davide97g/keybordy/cad/out/stl/plate.stl

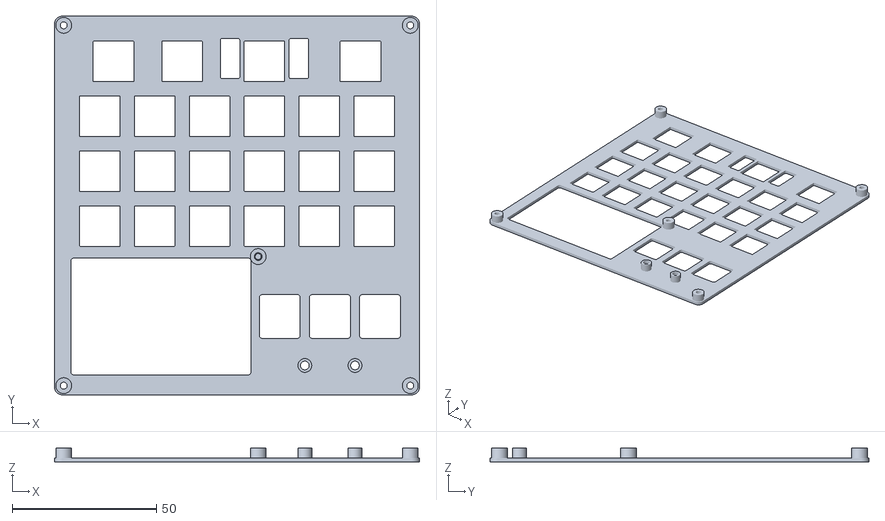
[picture p3: CAD file, 2026-10-20]
cad/out/stl/plate.stl
126.7 x 131.5 x 5.00
