davide97g/keybordy/cad/out/stl/tray.stl

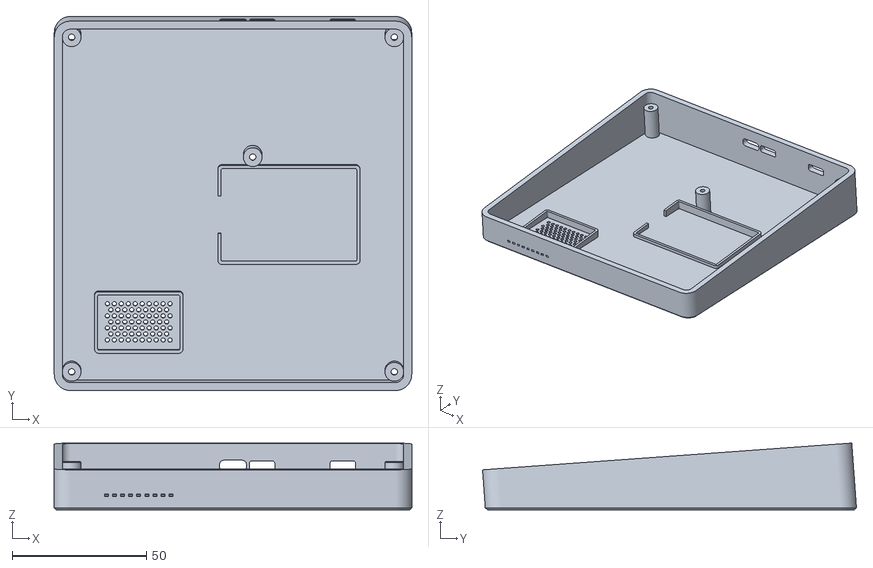
[picture p4: CAD file, 2026-10-20]
cad/out/stl/tray.stl
133.3 x 139.4 x 24.9
