davide97g/keybordy/cad/out/stl/cap15.stl

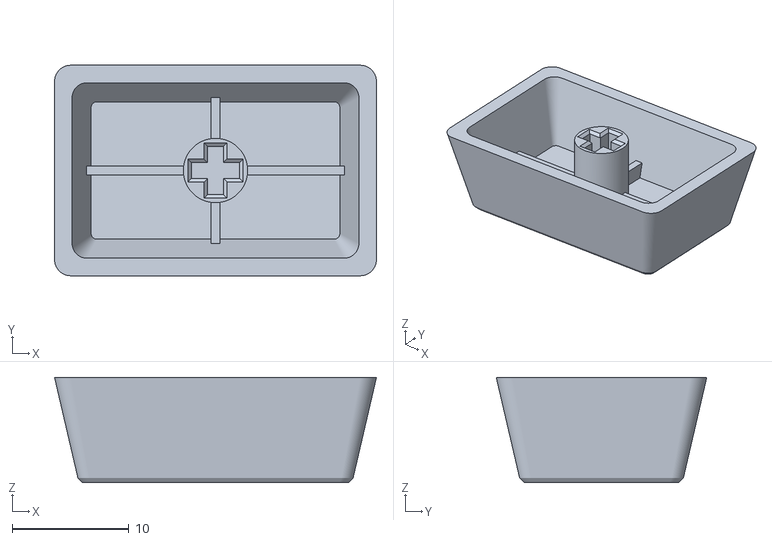
[picture p5: CAD file, 2026-10-20]
cad/out/stl/cap15.stl
27.5 x 18.0 x 9.00
