davide97g/keybordy/cad/out/stl/cap1.stl

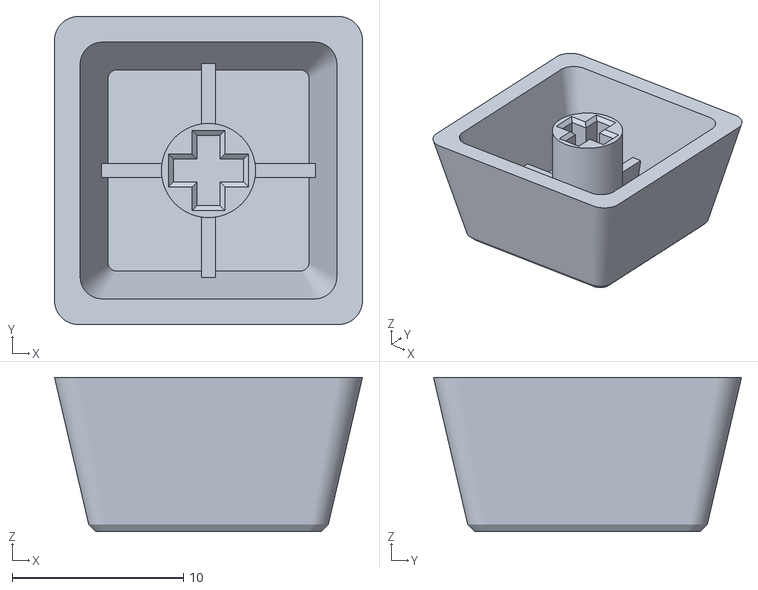
[picture p6: CAD file, 2026-10-20]
cad/out/stl/cap1.stl
18.0 x 18.0 x 9.00
