davide97g/keybordy/cad/out/stl/cap2_talk.stl

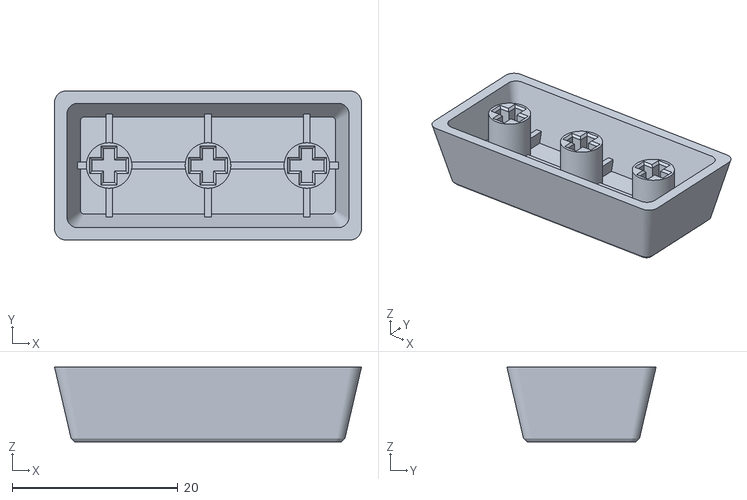
[picture p7: CAD file, 2026-10-20]
cad/out/stl/cap2_talk.stl
37.0 x 18.0 x 9.00
