davide97g/keybordy/cad/out/stl/deck.stl

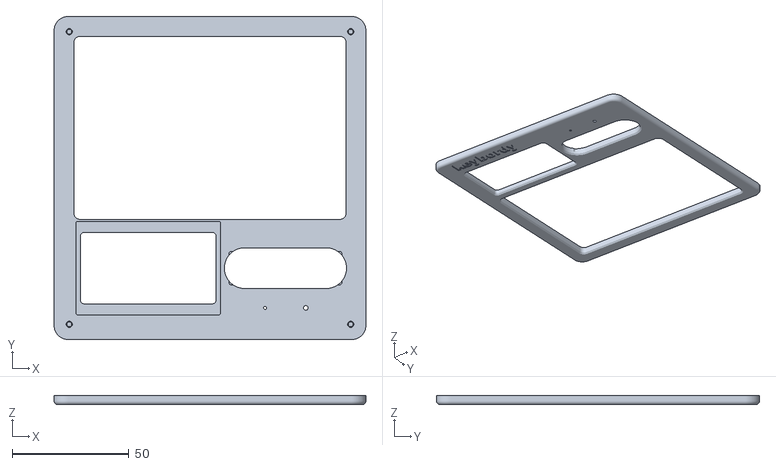
[picture p8: CAD file, 2026-10-20]
cad/out/stl/deck.stl
133.3 x 138.1 x 4.00
