davide97g/keybordy/cad/out/stl/knob.stl

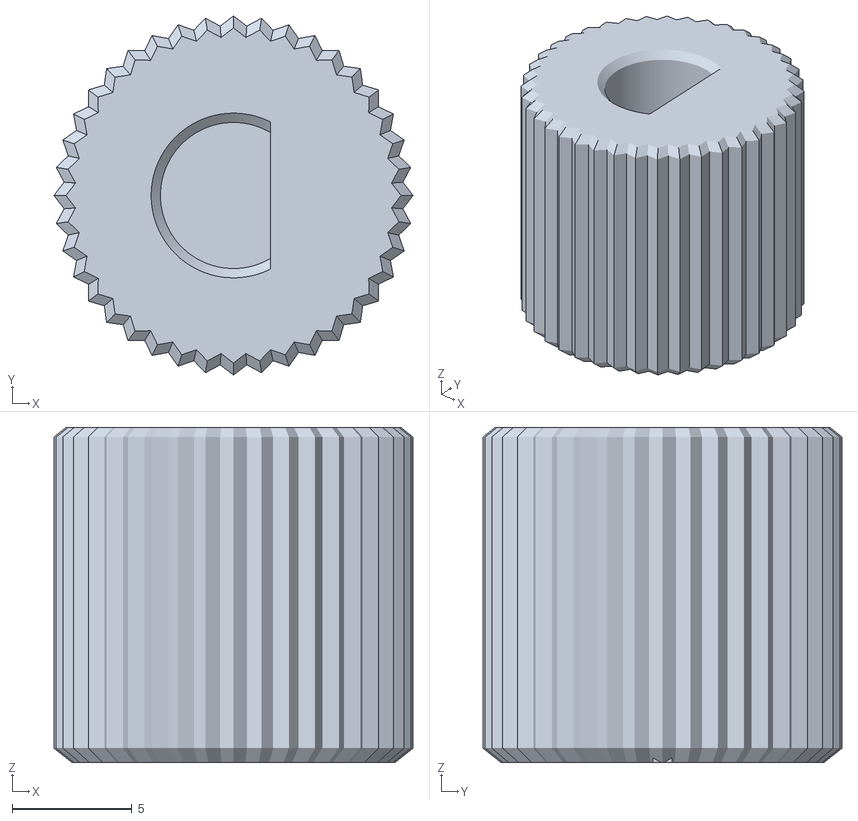
[picture p9: CAD file, 2026-10-20]
cad/out/stl/knob.stl
15.0 x 15.0 x 14.0
