davide97g/keybordy/pcb/keybordy.kicad_pcb

## KiCad design pcb/keybordy.kicad_pcb (2026-10-07)

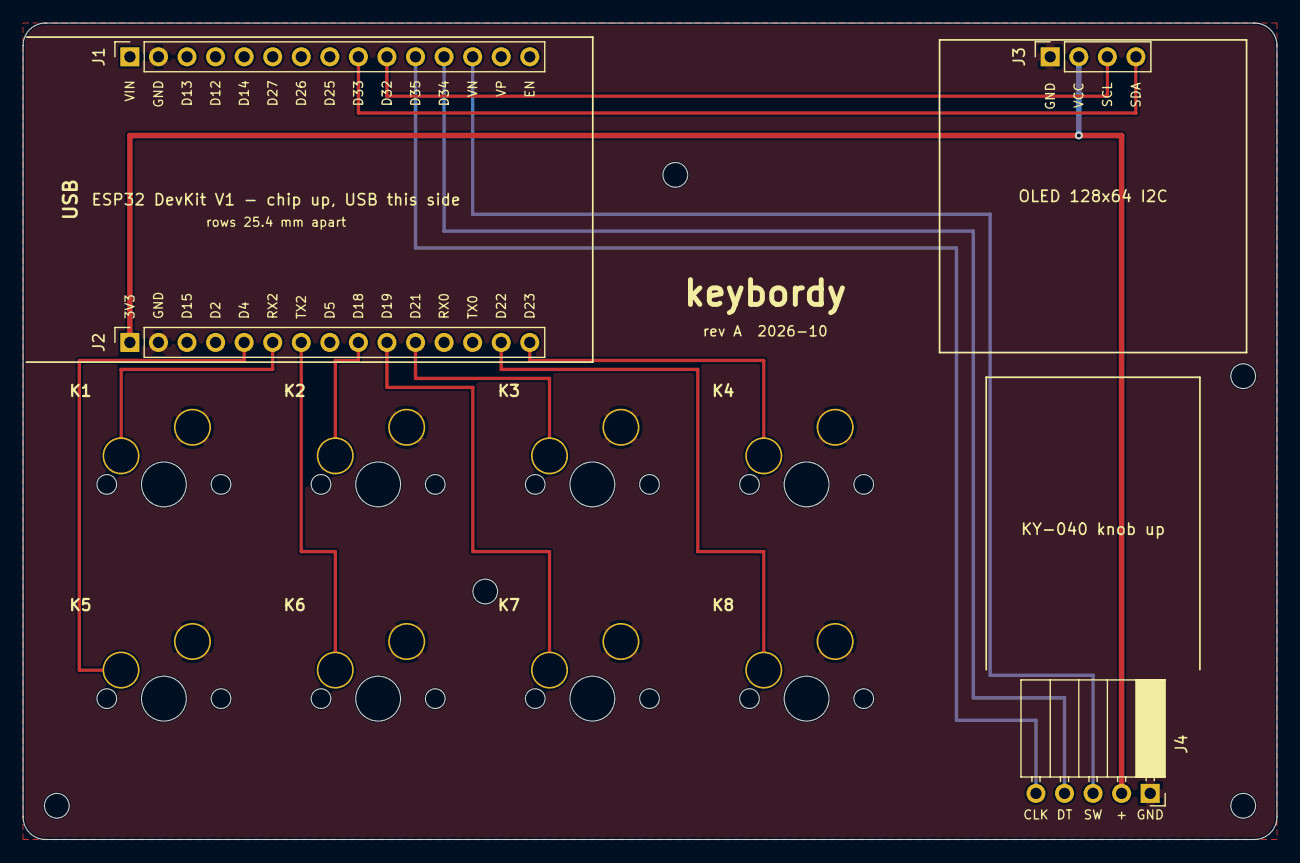
[picture p10: board keybordy.kicad_pcb from above]

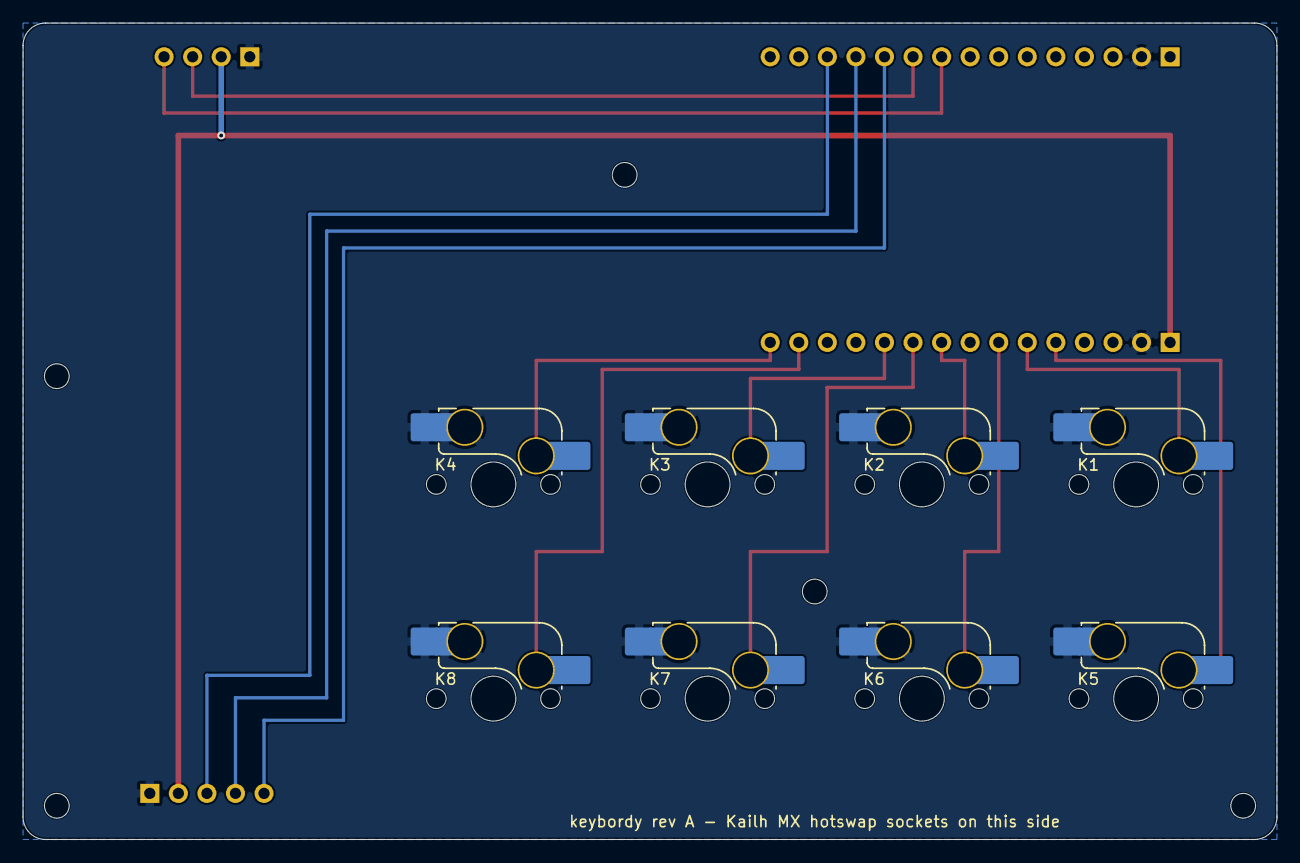
[picture p11: board keybordy.kicad_pcb from below]

Board: 2 copper layers, 111.5 x 72.6 mm, 17 parts (8 on the bottom side), 15 nets.

Parts:
H1, H2, H3, H4, H5: M2; MountingHole_2.2mm_M2
J1: DevKit top row; PinSocket_1x15_P2.54mm_Vertical
J2: DevKit bottom row; PinSocket_1x15_P2.54mm_Vertical
J3: SSD1306 OLED; PinSocket_1x04_P2.54mm_Vertical
J4: KY-040 rotary; PinSocket_1x05_P2.54mm_Horizontal
K1, K2, K3, K4, K5, K6, K7, K8: Kailh MX hotswap; SW_MX_HS_CPG151101S11_1u

Connections:
+3V3: J2.1, J3.2, J4.2
GND: J1.2, J2.2, J3.1, J4.1, K1.2, K2.2, K3.2, K4.2, K5.2, K6.2, K7.2, K8.2
KEY1: J2.6, K1.1
KEY2: J2.9, K2.1
KEY3: J2.11, K3.1
KEY4: J2.15, K4.1
KEY5: J2.5, K5.1
KEY6: J2.7, K6.1
KEY7: J2.10, K7.1
KEY8: J2.14, K8.1
OLED_SCL: J1.10, J3.3
OLED_SDA: J1.9, J3.4
ROT_CLK: J1.11, J4.5
ROT_DT: J1.12, J4.4
ROT_SW: J1.13, J4.3
