davide97g/keybordy/sim/velxio/backend/app/services/espidf_compiler.py

"""
ESP-IDF Compilation Service for ESP32 targets.

Replaces arduino-cli for ESP32/ESP32-C3 compilation.  User Arduino sketches
are compiled using ESP-IDF (with optional Arduino-as-component) to produce
firmware that boots reliably in the lcgamboa QEMU fork.

The key difference vs arduino-cli: ESP-IDF gives control over bootloader,
sdkconfig, and flash mapping — all of which must be QEMU-compatible.

Two compilation modes:
  1. Arduino-as-component: Full Arduino API (WiFi.h, WebServer.h, etc.)
     compiled through idf.py.  Requires ARDUINO_ESP32_PATH env var.
  2. Pure ESP-IDF: Translates common Arduino patterns to ESP-IDF C APIs.
     Fallback when Arduino component is not installed.
"""
import asyncio
import base64
import hashlib
import json
import logging
import os
import re
import shutil
import string
import subprocess
import tempfile
import threading
import time
from collections import deque
from contextvars import ContextVar
from dataclasses import dataclass
from pathlib import Path, PurePosixPath
from typing import Callable, Optional

logger = logging.getLogger(__name__)

# Per-task timing of the LAST compile() call: how long it waited for its build
# dir, whether the configure was skipped, and how long cmake / ninja ran. A
# caller can read it right after `await compile()` (same asyncio task, so the
# ContextVar is visible). Kept out of the result dict on purpose: the result is
# what the client receives, and these are diagnostics, not user-facing.
build_timing: ContextVar[Optional[dict]] = ContextVar('espidf_build_timing', default=None)


def _timing_note(**fields) -> None:
    current = build_timing.get() or {}
    current.update(fields)
    build_timing.set(current)


# Set VELXIO_ESPIDF_ALWAYS_CONFIGURE=1 to run `cmake` before every ninja run
# (the pre-2026-09 behaviour) without rebuilding the image. The default lets a
# warm build dir go straight to ninja, which re-runs cmake by itself when a
# configure input changed (build.ninja's RERUN_CMAKE rule).
_ALWAYS_CONFIGURE = (
    os.environ.get('VELXIO_ESPIDF_ALWAYS_CONFIGURE', '')
    in ('1', 'true', 'True', 'yes')
)


def _write_if_changed(path: Path, text: str) -> bool:
    """Write `text` to `path` only when the bytes differ. Returns True if written.

    Every generated file that cmake lists as a configure dependency
    (partitions.csv, velxio_board.cmake, a component's CMakeLists.txt) must go
    through here: an unconditional write bumps the mtime, and ninja's
    RERUN_CMAKE rule then re-runs the whole configure for a file that did not
    change. That configure is 60% of a warm ESP32 build (measured 2026-09-04).
    """
    try:
        if path.exists() and path.read_text(encoding='utf-8') == text:
            return False
    except (OSError, UnicodeDecodeError):
        pass
    path.write_text(text, encoding='utf-8')
    return True


# Location of the ESP-IDF project template (relative to this file)
_TEMPLATE_DIR = Path(__file__).parent / 'esp-idf-template'

# Files this pipeline owns inside main/ in Arduino mode: the app_main() wrapper
# that calls setup()/loop() (main.cpp), the pure-C twin the template ships,
# the translated sketch, the compat header and the two configure inputs. A
# user file with one of these names used to be written straight over them.
# Measured 2026-09-15: a project carrying its own `main.cpp` (a helper, no
# app_main) shadowed the wrapper, left a main.cpp.obj without the symbol in
# the shared variant dir, and every Arduino build that landed there for the
# next nine hours failed with "undefined reference to app_main" (573 builds,
# 73 users). Compared case-insensitively: on a Windows or macOS host
# Main.cpp and main.cpp are the same file.
_MAIN_RESERVED_NAMES = frozenset(n.casefold() for n in (
    'main.cpp',
    'main.c',
    'sketch.ino.cpp',
    'sketch_translated.c',
    'velxio_compat.h',
    'CMakeLists.txt',
    'idf_component.yml',
))
_USER_FILE_PREFIX = 'user_'
# What the template's main/CMakeLists.txt globs into the main component.
_COMPILED_SUFFIXES = ('.c', '.cpp')


def _user_main_name(name: str) -> str | None:
    """File name inside main/ that a user file is written under in Arduino
    mode, or None when the name is unusable.

    Only the last path component is kept, the way the pure ESP-IDF branch
    already does it. main/ is flat: the template CMake globs its top level
    only (a source in a sub-directory never compiled) and the write never
    created the parent (it crashed instead). And a name with '..' or an
    absolute path must never leave main/: the process runs as root in a build
    dir other users share. A basename the template owns gets the `user_`
    prefix, so the user's code still compiles and the wrapper stays.
    """
    base = PurePosixPath(str(name or '').replace('\\', '/')).name
    if base in ('', '.', '..'):
        return None
    if base.casefold() in _MAIN_RESERVED_NAMES:
        return _USER_FILE_PREFIX + base
    return base


def _defines_app_main(code: str) -> bool:
    """True when real code (not a comment or a string) defines app_main()."""
    return bool(re.search(r'\bvoid\s+app_main\s*\(', _blank_noncode(code)))


def _missing_app_main(output: str) -> bool:
    """The link failed because nothing defined app_main()."""
    return "undefined reference to `app_main'" in output


def _write_arduino_user_files(
    main_dir: Path,
    files: list[dict],
    entry_file: dict | None,
    progress_callback: Optional[Callable[[str], None]] = None,
) -> str | None:
    """Write the non-.ino files of an Arduino-mode build into main/.

    Returns an error message for the user, or None.

    - `entry_file` is the file compile() used as the sketch because there is
      no .ino (files[0]). It already reaches the build as sketch.ino.cpp, so a
      .c/.cpp entry is not written again (it used to compile twice, once as
      C). A header entry is still written: other files include it.
    - Names go through _user_main_name: flattened, kept inside main/, and a
      name the template owns renamed to `user_<name>`.
    - Two files that would land on the same name are an error, not a silent
      overwrite.
    - A user source that defines its own app_main() replaces the template
      wrapper for this build. That is a custom entry point, and it used to
      work by overwriting main.cpp, so it has to keep working. The wrapper is
      deleted rather than shadowed; it comes back from the template on the
      next build and _advance_changed_inputs gives it a new mtime, so no
      object from this build can outlive it.
    """
    def note(text: str) -> None:
        logger.warning(f'[espidf] {text}')
        if progress_callback is not None:
            try:
                progress_callback(f'[velxio] {text}\n')
            except Exception:
                pass

    written: dict[str, str] = {}
    custom_entry: str | None = None
    for f in files:
        name = str(f.get('name') or '')
        if name.endswith('.ino'):
            continue
        if f is entry_file and name.endswith(_COMPILED_SUFFIXES):
            continue
        target = _user_main_name(name)
        if target is None:
            note(f'skipped a file with an unusable name: {name!r}')
            continue
        if target in written:
            return (
                f'"{name}" and "{written[target]}" would both be compiled as '
                f'{target}. Rename one of them.'
            )
        written[target] = name
        if target != PurePosixPath(name.replace('\\', '/')).name:
            note(
                f'{name} is a name the build wrapper uses; your file is '
                f'compiled as {target}'
            )
        content = f.get('content', '')
        (main_dir / target).write_text(content, encoding='utf-8')
        if (
            custom_entry is None
            and target.endswith(_COMPILED_SUFFIXES)
            and _defines_app_main(content)
        ):
            custom_entry = target
    if custom_entry is not None:
        (main_dir / 'main.cpp').unlink(missing_ok=True)
        note(
            f'{custom_entry} defines app_main(); it replaces the Arduino '
            'setup()/loop() wrapper'
        )
    return None


# Per variant: what each tracked input held, and the mtime it was left with.
_INPUT_DIGESTS = '.velxio-input-digests.json'
# The per-build inputs this pipeline recreates (the rest of the project dir is
# either generated through _write_if_changed or owned by cmake/ninja).
_TRACKED_INPUT_DIRS = ('main', 'user_libs')


def _advance_changed_inputs(project_dir: Path) -> int:
    """Keep ninja's mtime test honest for every file this pipeline recreates.

    ninja rebuilds an object only when one of its inputs is NEWER than it.
    Everything under main/ and user_libs/ is recreated on every build, and
    copytree / copy2 hand each file the mtime of its SOURCE: the template's
    (months old) or the library cache's. A path whose content changes while
    its mtime stays in the past therefore keeps the object built from the old
    content, forever, in a build dir other users share. That is the 2026-09-15
    outage (a user main.cpp left a main.cpp.obj without app_main, the wrapper
    came back with its June mtime, and ninja never looked at it again), and a
    library version bump in the scan-all view has the same shape.

    The invariant: for a given path the mtime never goes backwards, and it
    moves forward whenever the content changes.
      - content differs from the last build, or the path is new: mtime = now
      - same content, but the copy moved the mtime into the past: the mtime it
        had after the last build is restored, so nothing rebuilds needlessly
      - same content, same or newer mtime: left alone (a warm build stays warm)
    A dir with no record yet treats every file as changed. That costs one
    rebuild of the main component and the user libraries (ccache hits), and it
    repairs a dir poisoned before this existed.

    Returns the number of files whose mtime was moved.
    """
    record_path = project_dir / _INPUT_DIGESTS
    try:
        previous = json.loads(record_path.read_text(encoding='utf-8'))
        if not isinstance(previous, dict):
            previous = {}
    except (OSError, ValueError):
        previous = {}
    now_ns = time.time_ns()
    current: dict[str, list] = {}
    moved = 0
    for root_name in _TRACKED_INPUT_DIRS:
        root = project_dir / root_name
        if not root.is_dir():
            continue
        for dirpath, _dirnames, filenames in os.walk(root):
            for fname in filenames:
                path = Path(dirpath) / fname
                if path.is_symlink() or not path.is_file():
                    continue
                rel = path.relative_to(project_dir).as_posix()
                try:
                    digest = hashlib.sha256(path.read_bytes()).hexdigest()
                    mtime_ns = path.stat().st_mtime_ns
                except OSError:
                    continue
                prev = previous.get(rel)
                target_ns = None
                if not (isinstance(prev, list) and len(prev) == 2 and prev[0] == digest):
                    target_ns = now_ns
                elif isinstance(prev[1], int) and mtime_ns < prev[1]:
                    target_ns = prev[1]
                if target_ns is not None:
                    try:
                        os.utime(path, ns=(target_ns, target_ns))
                        mtime_ns = target_ns
                        moved += 1
                    except OSError:
                        pass
                current[rel] = [digest, mtime_ns]
    try:
        tmp = project_dir / (_INPUT_DIGESTS + '.tmp')
        tmp.write_text(json.dumps(current), encoding='utf-8')
        os.replace(tmp, record_path)
    except OSError:
        pass
    return moved


# ── Persistent build dir ─────────────────────────────────────────────────────
# Cold ESP-IDF compiles rebuild ~1480 base objects (FreeRTOS, lwIP, esp_wifi,
# libsodium, …). The default tempfile.TemporaryDirectory flow gave each compile
# a fresh path under /tmp/espidf_<random>/, which baked into -I and
# -fmacro-prefix-map flags and made ccache 0% effective (different cwd → hash
# miss every time). With the persistent dir, /var/lib/velxio-build/<target>/
# is a stable anchor: ninja's incremental cache + ccache hits combine to bring
# warm compiles down to ~5-30s.
#
# Concurrent compiles in the SAME variant dir would corrupt it; they're
# serialised by _variant_lock below (one lock per variant, or per replica of a
# variant). Different variants of one target, and different targets, run in
# parallel up to the build queue's slot count.
#
# Set VELXIO_PERSISTENT_BUILD_DIR=0 to fall back to the legacy tempfile flow
# without rebuilding the image (escape hatch if the persistent dir misbehaves
# in production).
_BUILD_ROOT = Path(os.environ.get('VELXIO_BUILD_ROOT', '/var/lib/velxio-build'))
_USE_PERSISTENT_DIR = (
    os.environ.get('VELXIO_PERSISTENT_BUILD_DIR', '1')
    not in ('0', 'false', 'False', '')
)


# ── Per-library include roots (Arduino-faithful layout) ──────────────────────
# The merged `user_libs_all` component used to copy every library's files into
# ONE interleaved tree and then put EVERY directory that held a file on the
# component's public INCLUDE_DIRS. That is the root cause of the header-shadow
# bug class: a library's private internals — FastLED's host-test
# `src/platforms/stub/Arduino.h`, its `src/fl/stl/asio/http/http_parser.h`,
# LovyanGFX's `src/lgfx/internal/limits.h` — landed on the global -I and
# hijacked `#include`s issued by OTHER libraries, by the arduino-esp32 core and
# by ESP-IDF itself. Every fix was another name in `_SHADOW_STD_HEADERS`, i.e.
# chasing symptoms: the denylist grows with every library that ships a
# generically-named internal header.
#
# arduino-cli — the resolver every other Velxio board family already delegates
# to — shares one global -I list too, but adds exactly ONE directory per
# library: `<lib>/src` for the recursive layout, `<lib>` for the legacy flat
# one, never a subdirectory (its header index is non-recursive, so
# `src/sub/foo.h` is only ever reachable as `<sub/foo.h>`). `utility/` stays
# private to the library that owns it. arduino-esp32 does the same as an IDF
# component: one public include dir per bundled library.
#
# So: keep the single component — a component per library would trade this bug
# for REQUIRES-order shadowing (IDF exports component includes as plain -I,
# never -isystem) plus IDF-component name collisions — but give each library
# its own subtree and publish only its include root.
#
# Set VELXIO_PER_LIB_ROOTS=0 to fall back to the legacy interleaved layout
# without rebuilding the image (rollback hatch).
_PER_LIB_ROOTS = (
    os.environ.get('VELXIO_PER_LIB_ROOTS', '1')
    not in ('0', 'false', 'False', '')
)


# Directories a library ships that are never compiled: documentation and
# support material per the Arduino library spec. Headers found ONLY here do
# not get to add dependencies to the build (see the transitive scan below).
_SUPPORT_ONLY_DIRS = frozenset({
    'extras', 'examples', 'example', 'test', 'tests', 'docs', 'doc',
    'benchmark', 'benchmarks', 'fuzz', 'fuzzing', 'ci',
})

# A compiled source reaching into one of those dirs, e.g. FirebaseJson's
# `#include "extras/print/printf.h"` or FastLED's unity build.
_SUPPORT_INCLUDE_RE = re.compile(
    r'#\s*include\s*[<"][^">]*\b(?:%s)/' % '|'.join(sorted(_SUPPORT_ONLY_DIRS)),
    re.IGNORECASE,
)


def _sanitise_lib_dirname(name: str) -> str:
    """Component-relative directory name for a library.

    Cache folder names carry `@version-hash` suffixes (`fastled@3.10.5-017d…`)
    and user libs can be named anything; keep the characters that are safe in a
    path AND inside a quoted CMake string, fold the rest.
    """
    safe = re.sub(r'[^A-Za-z0-9_.@-]', '_', name).strip('.')
    return safe or 'lib'


def _idf_version_signature() -> str:
    """Snapshot of the ESP-IDF + arduino-esp32 toolchain version. Used to
    invalidate persistent build dirs after an upstream submodule bump (the
    cached object files on disk are no longer ABI-compatible)."""
    parts = []
    idf_version_file = Path('/opt/esp-idf/version.txt')
    if idf_version_file.exists():
        parts.append(idf_version_file.read_text(encoding='utf-8').strip())
    arduino_version_file = Path('/opt/arduino-esp32/version.txt')
    if arduino_version_file.exists():
        parts.append(arduino_version_file.read_text(encoding='utf-8').strip())
    if not parts:
        # Fall back to mtime of the IDF tree root — coarse but stable per
        # image build.
        try:
            parts.append(str(int(Path('/opt/esp-idf').stat().st_mtime)))
        except OSError:
            parts.append('unknown')
    return '|'.join(parts)


# Type for live progress callback. Called from a worker thread for every
# stdout/stderr line as the build runs. Implementations should be cheap and
# thread-safe (callers commonly stash lines into a dict shared with the main
# event loop). Exceptions raised from the callback are swallowed so a faulty
# UI hook can never break the build.
ProgressCallback = Callable[[str], None]


@dataclass
class _RunResult:
    """Drop-in replacement for the fields we read off subprocess.CompletedProcess."""
    returncode: int
    stdout: str
    stderr: str


def _nice_preexec(nice: int | None):
    """preexec_fn that lowers the child's CPU priority. None = inherit.

    The API and the simulation WebSockets share the box with the compilers;
    a positive nice keeps them responsive under a full CPU. Background
    replica warm-ups run at nice 10 so they never compete with a build
    someone is waiting on.
    """
    if not nice or os.name == 'nt':
        return None

    def _apply() -> None:
        try:
            os.nice(int(nice))
        except OSError:
            pass
    return _apply


def _run_with_streaming(
    cmd: list[str],
    *,
    cwd: str,
    env: dict[str, str],
    timeout: float,
    progress_callback: Optional[ProgressCallback],
    nice: int | None = None,
) -> _RunResult:
    """Run `cmd` synchronously and stream stdout + stderr line-by-line.

    Behaves like subprocess.run(capture_output=True, text=True) but invokes
    `progress_callback(line)` for every line as it arrives. When
    progress_callback is None this falls back to a single subprocess.run call
    so we don't pay the threading cost on the unit-test path that doesn't
    care about live output.

    Raises subprocess.TimeoutExpired on timeout (matches the existing flow).
    """
    preexec = _nice_preexec(nice)
    if progress_callback is None:
        cp = subprocess.run(
            cmd, cwd=cwd, env=env, capture_output=True, text=True, timeout=timeout,
            preexec_fn=preexec,
        )
        return _RunResult(returncode=cp.returncode, stdout=cp.stdout, stderr=cp.stderr)

    proc = subprocess.Popen(
        cmd,
        cwd=cwd,
        env=env,
        stdout=subprocess.PIPE,
        stderr=subprocess.PIPE,
        text=True,
        bufsize=1,  # line-buffered
        preexec_fn=preexec,
    )
    stdout_lines: list[str] = []
    stderr_lines: list[str] = []

    def _drain(stream, sink: list[str]) -> None:
        try:
            for line in iter(stream.readline, ''):
                sink.append(line)
                try:
                    progress_callback(line)
                except Exception:
                    # A faulty progress sink must never break the build.
                    pass
        finally:
            try:
                stream.close()
            except Exception:
                pass

    t_out = threading.Thread(target=_drain, args=(proc.stdout, stdout_lines), daemon=True)
    t_err = threading.Thread(target=_drain, args=(proc.stderr, stderr_lines), daemon=True)
    t_out.start()
    t_err.start()

    try:
        proc.wait(timeout=timeout)
    except subprocess.TimeoutExpired:
        proc.kill()
        # Give drain threads a chance to flush before we raise.
        t_out.join(timeout=2)
        t_err.join(timeout=2)
        raise

    t_out.join(timeout=5)
    t_err.join(timeout=5)
    return _RunResult(
        returncode=proc.returncode,
        stdout=''.join(stdout_lines),
        stderr=''.join(stderr_lines),
    )


# How many distinct build variants to keep per target before LRU-evicting the
# coldest. Each variant is a full ESP-IDF build tree (~240 MB). Distinct
# variants = distinct (board options x resolved library set). The global ccache
# means an evicted-then-rebuilt variant warms up in seconds.
# Was 12. Each variant is a FULL ~1 GB build tree holding its own copies of
# the same ESP-IDF component objects, so 46 of them had grown to 25 GB while
# ccache - the cache that actually serves EVERY target and variant - sat
# capped at 8 GB, permanently full (99.97%, 153 evictions, 47% hit rate).
# Fewer trees, a bigger shared cache: a variant that gets evicted rebuilds
# quickly FROM ccache, but a ccache miss recompiles from source.
_MAX_BUILD_VARIANTS = 6


def _max_build_variants(idf_target: str) -> int:
    """Variant cap for one target: VELXIO_BUILD_VARIANTS_<TARGET> (e.g.
    VELXIO_BUILD_VARIANTS_ESP32), else VELXIO_BUILD_VARIANTS, else the module
    default. Per target because on a busy server the hot target rotates through
    10 distinct variants in half an hour while the others idle at two."""
    for name in (f'VELXIO_BUILD_VARIANTS_{idf_target.upper()}', 'VELXIO_BUILD_VARIANTS'):
        raw = os.environ.get(name, '').strip()
        if raw:
            try:
                return max(1, min(64, int(raw)))
            except ValueError:
                logger.warning(f'[espidf] {name}={raw!r} is not an integer; ignored')
    return _MAX_BUILD_VARIANTS


# ── Replicas of a hot variant ────────────────────────────────────────────────
# Two compiles that hash to the SAME variant serialise on its lock, and on
# a busy multi-user server the dominant configuration (the default esp32 blink,
# no libraries) was 78% of all ESP-IDF builds: the second heavy slot spent its time
# holding a slot while waiting for the first one's directory. A replica is a
# second full copy of the variant (`v_<hash>_r1`), configured on first use and
# then as warm as the original, with its own lock. A compile picks the first
# replica whose lock is free. Replicas are only CREATED after the variant has
# been found busy a few times in a short window, so a one-off library
# combination never earns a second 400 MB tree.
def _variant_replicas() -> int:
    raw = os.environ.get('VELXIO_BUILD_VARIANT_REPLICAS', '').strip()
    if not raw:
        return 1
    try:
        return max(1, min(8, int(raw)))
    except ValueError:
        logger.warning(f'[espidf] VELXIO_BUILD_VARIANT_REPLICAS={raw!r} is not an integer; using 1')
        return 1


_REPLICA_COLLISION_THRESHOLD = 3     # busy hits before a new replica is created
_REPLICA_COLLISION_WINDOW_S = 600.0  # ...within this many seconds
_VARIANT_COLLISIONS: dict[str, deque] = {}
#: Lock keys of replicas being built in the background right now. A replica
#: is warmed by a background compile of the SAME sources (so its configure
#: matches the variant) rather than by the user's job that hit the collision:
#: a cold build is 30-75 s and that job would rather wait a few seconds for
#: the original. While warming, the replica is neither picked nor re-created.
_WARMING_REPLICAS: set[str] = set()
_BACKGROUND_TASKS: set = set()


def _note_variant_collision(base_key: str) -> bool:
    """Record that every replica of `base_key` was busy. True when the streak
    is long enough to justify creating the next replica."""
    now = time.monotonic()
    hits = _VARIANT_COLLISIONS.setdefault(base_key, deque())
    hits.append(now)
    while hits and now - hits[0] > _REPLICA_COLLISION_WINDOW_S:
        hits.popleft()
    return len(hits) >= _REPLICA_COLLISION_THRESHOLD


def _variant_dir_name(variant_key: str, replica: int = 0) -> str:
    safe = ''.join(c for c in variant_key if c.isalnum() or c in '-_')[:40] or 'default'
    return 'v_' + safe + (f'_r{replica}' if replica else '')


def _variant_lock_key(idf_target: str, variant_key: str, replica: int = 0) -> str:
    base = f'{idf_target}/{variant_key}'
    return base if not replica else f'{base}/r{replica}'


_VARIANT_DIR_RE = re.compile(r'^v_(.+?)(?:_r(\d+))?$')


def _lock_key_for_variant_dir(idf_target: str, dirname: str) -> str | None:
    """Inverse of _variant_dir_name: the lock key a `v_*` directory is built
    under, so eviction can tell whether someone is compiling in it."""
    m = _VARIANT_DIR_RE.match(dirname)
    if not m:
        return None
    return _variant_lock_key(idf_target, m.group(1), int(m.group(2) or 0))


# One compile at a time per build variant. The build queue bounds how many
# compiles run at once, not WHERE they run: two requests that hash to the same
# variant (the deploy gate's smoke fired the S3 OLED example twice, 13 s
# apart) shared one project dir, and the second configure walked into the
# first one's half-copied managed component. The component manager then
# reported it "corrupted" on every later attempt, and that variant was dead
# until someone deleted it by hand (2026-09-03).
_VARIANT_LOCKS: dict[str, asyncio.Lock] = {}
_VARIANT_LOCKS_GUARD = threading.Lock()


def _variant_lock(key: str) -> asyncio.Lock:
    """The lock that serialises compiles inside one persistent build variant."""
    with _VARIANT_LOCKS_GUARD:
        lock = _VARIANT_LOCKS.get(key)
        if lock is None:
            lock = _VARIANT_LOCKS[key] = asyncio.Lock()
        return lock


_CORRUPT_COMPONENT_RE = re.compile(
    r'The downloaded component "([^"]+)"\s+is\s+corrupted', re.IGNORECASE
)


def _corrupt_managed_component(stderr: str | None) -> str | None:
    """Name of the managed component the IDF component manager refused as
    corrupted (its message wraps across lines), or None for any other cmake
    failure."""
    m = _CORRUPT_COMPONENT_RE.search(stderr or '')
    return m.group(1) if m else None


def _heal_corrupt_managed_components(project_dir: Path, build_dir: Path) -> bool:
    """Drop the variant's managed_components/ (the component manager copies
    them back from its own intact cache on the next configure) and the cmake
    cache that recorded them. Returns True when there was something to drop."""
    removed = False
    managed = project_dir / 'managed_components'
    if managed.exists():
        shutil.rmtree(managed, ignore_errors=True)
        removed = True
    cache = build_dir / 'CMakeCache.txt'
    if cache.exists():
        cache.unlink(missing_ok=True)
        removed = True
    return removed


def _evict_cold_variants(target_dir: Path, keep: int, idf_target: str | None = None) -> None:
    """LRU-evict variant dirs (``v_*``) beyond ``keep``, coldest mtime first.

    Never evicts a variant whose lock is held: with two compiles of one target
    running at once (different variants, or replicas of one), the coldest
    sibling by mtime can be the one a long cold build is still writing into.
    Its mtime is stamped at prepare time and again when its build finishes
    (see _attempt), so a variant only looks cold once it has been idle.
    """
    try:
        variants = [
            d for d in target_dir.iterdir()
            if d.is_dir() and d.name.startswith('v_')
        ]
    except OSError:
        return
    if len(variants) <= keep:
        return
    target = idf_target or target_dir.name

    def _busy(d: Path) -> bool:
        key = _lock_key_for_variant_dir(target, d.name)
        if key is None:
            return False
        with _VARIANT_LOCKS_GUARD:
            lock = _VARIANT_LOCKS.get(key)
        return bool(lock is not None and lock.locked())

    variants.sort(key=lambda d: d.stat().st_mtime if d.exists() else 0.0)
    excess = len(variants) - keep
    for d in variants:
        if excess <= 0:
            break
        if _busy(d):
            logger.info(f'[espidf] not evicting {d.name}: a compile holds its lock')
            continue
        logger.info(f'[espidf] LRU-evicting cold build variant {d.name}')
        shutil.rmtree(d, ignore_errors=True)
        excess -= 1


def _ninja_parallelism_args() -> list[str]:
    """`-j N` / `-l L` for ninja from VELXIO_NINJA_JOBS / VELXIO_NINJA_LOAD_LIMIT.

    Unset (the default) leaves ninja's own choice, nproc + 2. Two heavy slots
    on 6 vCPU, where two such ninjas plus the light lane measured 34 runnable
    compiler threads at peak, are what these knobs are for. `-l` throttles on the 1-minute load average, so a
    build alone still gets the whole box.
    """
    args: list[str] = []
    raw_jobs = os.environ.get('VELXIO_NINJA_JOBS', '').strip()
    if raw_jobs:
        try:
            jobs = int(raw_jobs)
            if jobs > 0:
                args += ['-j', str(jobs)]
        except ValueError:
            logger.warning(f'[espidf] VELXIO_NINJA_JOBS={raw_jobs!r} is not an integer; ignored')
    raw_load = os.environ.get('VELXIO_NINJA_LOAD_LIMIT', '').strip()
    if raw_load:
        try:
            load = float(raw_load)
            if load > 0:
                args += ['-l', str(load)]
        except ValueError:
            logger.warning(f'[espidf] VELXIO_NINJA_LOAD_LIMIT={raw_load!r} is not a number; ignored')
    return args


_CONFIGURE_TROUBLE_MARKERS = (
    'CMake Error',
    'ninja: error',
    'missing and no known rule to make it',
    'error: loading \'build.ninja\'',
)


def _ninja_failure_wants_configure(result: _RunResult) -> bool:
    """True when a failed ninja run on a warm dir looks like a configure
    problem (cmake re-run failed, an input vanished, a manifest changed) rather
    than a compiler error in the user's code. The fast path falls back to the
    explicit configure exactly once on these."""
    text = (result.stdout or '') + '\n' + (result.stderr or '')
    if _corrupt_managed_component(text):
        return True
    return any(marker in text for marker in _CONFIGURE_TROUBLE_MARKERS)


def _ninja_log_step_count(build_dir: 'str | Path') -> int:
    """Number of completed build steps recorded in ``build_dir/.ninja_log``
    (0 when absent/unreadable). Diagnostics only — used to say how far a
    timed-out build got."""
    try:
        with open(Path(build_dir) / '.ninja_log', encoding='utf-8', errors='replace') as fh:
            return max(0, sum(1 for _ in fh) - 1)  # first line is the header
    except OSError:
        return 0


# ── .ino prototype generation ────────────────────────────────────────────────
# arduino-cli runs ctags over the sketch and injects forward declarations so
# the classic Arduino idiom — helpers defined AFTER setup()/loop() that use
# them — compiles. This pipeline writes sketch.ino.cpp itself and never did,
# so every such sketch died with "'foo' was not declared in this scope".
# This is a conservative ctags stand-in: it only emits prototypes for
# top-level, single-signature-line function definitions and skips anything
# ambiguous (templates, methods, default args, function-pointer params).

_INO_CTRL_KEYWORDS = frozenset((
    'if', 'else', 'for', 'while', 'switch', 'do', 'return', 'sizeof',
    'catch', 'case', 'new', 'delete', 'throw', 'goto',
))

_INO_FUNC_RE = re.compile(
    r'^[ \t]*([A-Za-z_][A-Za-z0-9_:<>,\*&\s]*?[\s\*&])'   # return type part
    r'([A-Za-z_]\w*)'                                      # function name
    r'[ \t]*\(([^;{}()]*)\)'                               # params (no nesting)
    r'[ \t\r\n]*\{',
    re.M,
)


def _blank_noncode(source: str) -> str:
    """Return a same-length copy with comments, string/char literals and
    preprocessor lines replaced by spaces (newlines preserved), so brace
    counting and signature matching never trip on their contents."""
    out = list(source)
    i, n = 0, len(source)
    line_start = True
    while i < n:
        c = source[i]
        if line_start and source[i:].lstrip(' \t')[:1] == '#':
            # blank the whole preprocessor line (incl. continuations)
            while i < n:
                if source[i] == '\n' and source[i - 1] != '\\':
                    break
                if source[i] != '\n':
                    out[i] = ' '
                i += 1
            line_start = True
            i += 1
            continue
        line_start = c == '\n'
        if c == '/' and i + 1 < n and source[i + 1] == '/':
            while i < n and source[i] != '\n':
                out[i] = ' '
                i += 1
            continue
        if c == '/' and i + 1 < n and source[i + 1] == '*':
            out[i] = out[i + 1] = ' '
            i += 2
            while i < n and not (source[i] == '*' and i + 1 < n and source[i + 1] == '/'):
                if source[i] != '\n':
                    out[i] = ' '
                i += 1
            if i < n:
                out[i] = out[i + 1] = ' '
                i += 2
            continue
        if c in ('"', "'"):
            quote = c
            i += 1
            while i < n and source[i] != quote:
                if source[i] == '\\':
                    out[i] = ' '
                    i += 1
                    if i < n and source[i] != '\n':
                        out[i] = ' '
                    i += 1
                    continue
                if source[i] != '\n':
                    out[i] = ' '
                i += 1
            i += 1
            continue
        i += 1
    return ''.join(out)


def generate_ino_prototypes(source: str) -> str:
    """Insert forward declarations for top-level function definitions right
    before the first one, followed by a #line directive so compiler error
    line numbers keep matching the un-inserted text. Returns the source
    unchanged when nothing safe to declare is found."""
    scan = _blank_noncode(source)

    # depth prefix: depth[i] = brace depth just before scan[i]
    depths = []
    d = 0
    for ch in scan:
        depths.append(d)
        if ch == '{':
            d += 1
        elif ch == '}':
            d = max(0, d - 1)

    protos: list[str] = []
    seen: set[str] = set()
    first_pos: int | None = None
    for m in _INO_FUNC_RE.finditer(scan):
        sig_start = m.start()
        if depths[m.end() - 1] != 0:
            continue  # method body / nested — the '{' must open at depth 0
        rtype = ' '.join(m.group(1).split())
        name = m.group(2)
        params = ' '.join(m.group(3).split())
        if not rtype or name in _INO_CTRL_KEYWORDS:
            continue
        first_tok = rtype.split()[0] if rtype.split() else ''
        if first_tok in _INO_CTRL_KEYWORDS:
            continue
        if '::' in rtype or '::' in name or 'operator' in rtype:
            continue  # class methods / operators declare themselves
        if '<' in rtype or '>' in rtype or 'template' in rtype.split():
            continue  # templated heads/returns — never guess those
        if '=' in params or '{' in params:
            continue  # default args would be re-stated -> hard error
        # a `template<...>` head on a preceding line makes a bare prototype wrong
        lookback = scan[max(0, sig_start - 160):sig_start]
        if re.search(r'template\s*<[^<>]*>\s*$', lookback):
            continue
        proto = f'{rtype} {name}({params});'
        if proto not in seen:
            seen.add(proto)
            protos.append(proto)
        if first_pos is None:
            first_pos = sig_start

    if not protos or first_pos is None:
        return source

    insert_line = source.count('\n', 0, first_pos) + 1
    block = (
        '// Velxio: auto-generated forward declarations (.ino semantics)\n'
        + '\n'.join(protos)
        + f'\n#line {insert_line}\n'
    )
    return source[:first_pos] + block + source[first_pos:]


# The toolchain-change wipe below removes EVERY variant of a target. It used
# to be safe by construction (prepare ran on the event loop, so two compiles
# could not interleave in it); now that prepare runs in a worker thread, two
# first-after-restart compiles of one target must not both decide to wipe.
_TARGET_SENTINEL_GUARD = threading.Lock()

# Where prepare stashes the previous build's generated user_libs CMakeLists so
# the merge can hand the regenerated file its old mtime when the bytes are
# identical (it is a configure dependency; a fresh mtime re-runs cmake).
_USERLIBS_CMAKE_STASH = '.velxio-userlibs-cmake.prev'
# The two configure inputs under main/ get the same treatment: prepare wipes
# main/ and restores it from the template, so both come back with a fresh
# mtime every build even when their bytes are the previous build's.
_MAIN_CMAKE_STASH = '.velxio-main-cmake.prev'
_MANIFEST_STASH = '.velxio-manifest.prev'


def _stash_for_next_build(src: Path, stash: Path) -> None:
    """Keep a copy of a configure input (bytes AND mtime) before main/ is
    wiped, or drop the stale stash when the input did not exist this time."""
    try:
        if src.is_file():
            shutil.copy2(src, stash)  # copy2 keeps the mtime
        else:
            stash.unlink(missing_ok=True)
    except OSError:
        pass


_MAIN_INCLUDE_TOKEN = 'INCLUDE_DIRS "."'
_USER_LIBS_INCLUDE_DIR = '"../user_libs/user_libs_all"'


def main_cmake_with_user_libs(cmake_text: str) -> str:
    """main/CMakeLists.txt with the merged library headers on main's include path.

    INCLUDE_DIRS is the ONLY thing to add. main names no REQUIRES on purpose:
    ESP-IDF then makes it depend on every component in the build, user_libs_all
    included (project.cmake does that only "when user did not set
    REQUIRES/PRIV_REQUIRES manually"). This function used to append
    user_libs_all to a REQUIRES line; writing one back would shrink the IDF a
    sketch can reach down to the named closure again, which is issue #342.
    """
    if _USER_LIBS_INCLUDE_DIR in cmake_text:
        return cmake_text
    return cmake_text.replace(
        _MAIN_INCLUDE_TOKEN, f'{_MAIN_INCLUDE_TOKEN} {_USER_LIBS_INCLUDE_DIR}')


def _restore_mtime_if_unchanged(path: Path, stash: Path) -> bool:
    """Give a regenerated configure input its previous mtime when its bytes
    did not change, so ninja's RERUN_CMAKE rule does not see it as new.

    Returns True when the bytes DIFFER from the stashed copy (or there was no
    stash): the caller then knows the configure has to run.
    """
    try:
        if not stash.is_file():
            return True
        if stash.read_text(encoding='utf-8') != path.read_text(encoding='utf-8'):
            return True
        st = stash.stat()
        os.utime(path, (st.st_atime, st.st_mtime))
        return False
    except (OSError, UnicodeDecodeError):
        return True


def _prepare_persistent_project_dir(
    idf_target: str,
    variant_key: str = 'default',
    replica: int = 0,
) -> Path:
    """Return a persistent project dir for (idf_target, variant_key), created
    from the template on first use and with the per-compile parts (main/,
    user_libs/) reset each call so a previous sketch doesn't leak into the next.

    Each distinct ``variant_key`` gets its OWN dir with its OWN ``build/`` that
    is NEVER wiped/reconfigured for a different config. The caller folds the
    board options AND the resolved library set into the key, so two compiles
    that would produce a different ESP-IDF component graph never share a build/.
    Sharing one build/ across configs caused intermittent cmake-configure
    failures, stale-object false positives, and nested-build breakage (a wiped+
    reconfigured dir loses ESP-IDF managed-component temp files). Same variant
    -> same dir -> warm ninja incremental + ccache. Cold variant -> fresh build,
    fast via the global ccache. The variant set is LRU-bounded per target.
    """
    target_dir = _BUILD_ROOT / idf_target
    target_dir.mkdir(parents=True, exist_ok=True)

    # Wipe ALL variants for this target if the toolchain changed (cached .o
    # files are no longer ABI-compatible).
    with _TARGET_SENTINEL_GUARD:
        sentinel = target_dir / '.idf_version'
        current_signature = _idf_version_signature()
        if sentinel.exists() and sentinel.read_text(encoding='utf-8').strip() != current_signature:
            logger.info(f'[espidf] toolchain version changed; wiping {target_dir}')
            shutil.rmtree(target_dir, ignore_errors=True)
            target_dir.mkdir(parents=True, exist_ok=True)
        sentinel.write_text(current_signature, encoding='utf-8')

    # One-time cleanup of the pre-variant layout (target_dir/project) so it
    # doesn't orphan ~240 MB after the upgrade to per-variant dirs.
    legacy_project = target_dir / 'project'
    if legacy_project.exists():
        shutil.rmtree(legacy_project, ignore_errors=True)
        (target_dir / '.options_hash').unlink(missing_ok=True)

    variant_dir = target_dir / _variant_dir_name(variant_key, replica)
    project_dir = variant_dir / 'project'

    if not project_dir.exists():
        variant_dir.mkdir(parents=True, exist_ok=True)
        shutil.copytree(_TEMPLATE_DIR, project_dir)
    else:
        # Reset per-compile parts only; keep build/ (warm for this variant).
        # copytree preserves the template's mtimes, so main/CMakeLists.txt
        # does NOT look new to ninja after this. That is also true of the
        # template's main.cpp, which is why _compile_in_dir runs
        # _advance_changed_inputs before ninja: an mtime copied from the
        # template must never let an object built from other content survive.
        # The top-level CMakeLists.txt came from the template when the variant
        # was created; bring a changed template to warm variants too (the
        # mtime moves only when the bytes differ, and ninja reconfigures).
        try:
            _write_if_changed(
                project_dir / 'CMakeLists.txt',
                (_TEMPLATE_DIR / 'CMakeLists.txt').read_text(encoding='utf-8'),
            )
        except OSError:
            pass
        # Both configure inputs under main/ are regenerated per build (the
        # CMakeLists patched for user_libs_all / IDF components, the managed
        # components manifest written from the sketch's includes). Keep the
        # previous build's copies so _compile_in_dir can hand back the old
        # mtime when the bytes match - and force the configure when the
        # manifest changed, which ninja cannot see (see _sync_managed_components).
        _stash_for_next_build(
            project_dir / 'main' / 'CMakeLists.txt', project_dir / _MAIN_CMAKE_STASH,
        )
        _stash_for_next_build(
            project_dir / 'main' / 'idf_component.yml', project_dir / _MANIFEST_STASH,
        )
        shutil.rmtree(project_dir / 'main', ignore_errors=True)
        shutil.copytree(_TEMPLATE_DIR / 'main', project_dir / 'main')
        _stash_for_next_build(
            project_dir / 'user_libs' / 'user_libs_all' / 'CMakeLists.txt',
            project_dir / _USERLIBS_CMAKE_STASH,
        )
        shutil.rmtree(project_dir / 'user_libs', ignore_errors=True)

    # Mark this variant most-recently-used, then LRU-evict the coldest.
    try:
        os.utime(variant_dir, None)
    except OSError:
        pass
    _evict_cold_variants(target_dir, keep=_max_build_variants(idf_target), idf_target=idf_target)

    return project_dir

# Static IP that matches slirp DHCP range (first client = x.x.x.15)
_STATIC_IP = '192.168.4.15'
_GATEWAY_IP = '192.168.4.2'
_NETMASK = '255.255.255.0'

# SSID the QEMU WiFi AP broadcasts.
# Must match one of the access_point_info entries in esp32_wifi_ap.c
# (the lcgamboa QEMU fork). "Espressif" is on channel 5 in that array.
_QEMU_WIFI_SSID = 'Espressif'
_QEMU_WIFI_CHANNEL = 5


class ESPIDFCompiler:
    """Compile Arduino sketches using ESP-IDF for QEMU-compatible output."""

    # Instance attributes resolved in __init__ (declared here so type
    # checkers see them without inferring through the discovery logic).
    idf_path: str          # pinned ESP-IDF v4.4.7 tree (Arduino fallback)
    idf5_path: str         # ESP-IDF v5.x tree (family default + only C6)
    arduino_path: str      # arduino-esp32 2.x core (IDF 4.4-based)
    arduino5_path: str     # arduino-esp32 3.x core (IDF 5.x-based)
    has_arduino: bool      # a usable 2.x core was found
    has_arduino5: bool     # a usable 3.x core was found

    def __init__(self):
        self.idf_path = os.environ.get('IDF_PATH', '')
        self.arduino_path = os.environ.get('ARDUINO_ESP32_PATH', '')
        self.has_arduino = bool(self.arduino_path) and os.path.isdir(self.arduino_path)

        # Try common locations on Windows dev machines
        if not self.idf_path:
            for candidate in [
                r'C:\Espressif\frameworks\esp-idf-v4.4.7',
                r'C:\esp\esp-idf',
                '/opt/esp-idf',
            ]:
                if os.path.isdir(candidate):
                    self.idf_path = candidate
                    break

        # Auto-detect the 2.x Arduino core (IDF 4.4-based) if not explicitly
        # set. This is the core used for Arduino sketches on the v4.4.7
        # fallback path (esp32/s2/s3/c3).
        if self.idf_path and not self.has_arduino:
            for candidate in [
                r'C:\Espressif\components\arduino-esp32',
                os.path.join(self.idf_path, '..', 'components', 'arduino-esp32'),
                '/opt/arduino-esp32',
            ]:
                if os.path.isdir(candidate):
                    self.arduino_path = os.path.abspath(candidate)
                    self.has_arduino = True
                    break

        # ── ESP-IDF v5.x root (IDF5-only targets: ESP32-C6) ─────────────
        # The pinned v4.4.7 tree has no esp32c6 target, so C6 builds resolve
        # a separate IDF v5.x install. Kept independent of self.idf_path so
        # the classic targets keep building against the known-good 4.4 tree.
        self.idf5_path = os.environ.get('IDF5_PATH', '')
        if not self.idf5_path:
            candidates5: list[str] = []
            win55 = Path(r'C:\Espressif5.5\frameworks')
            if win55.is_dir():
                # Newest first when several v5 frameworks are installed.
                candidates5 += sorted(
                    (str(p) for p in win55.glob('esp-idf-v5*')), reverse=True
                )
            candidates5.append('/opt/esp-idf-v5')
            for candidate in candidates5:
                if os.path.isdir(candidate):
                    self.idf5_path = candidate
                    break

        if self.idf_path:
            logger.info(f'[espidf] IDF_PATH={self.idf_path}')
            if self.has_arduino:
                logger.info(f'[espidf] Arduino component: yes ({self.arduino_path})')
            else:
                logger.info('[espidf] Arduino component: no (pure ESP-IDF fallback)')
        else:
            logger.warning('[espidf] IDF_PATH not set — ESP-IDF compilation unavailable')
        if self.idf5_path:
            logger.info(f'[espidf] IDF v5.x (esp32c6): {self.idf5_path}')
        else:
            logger.info('[espidf] IDF v5.x not found — esp32c6 compilation unavailable')

        # ── arduino-esp32 3.x core (IDF 5.x-based) ──────────────────────
        # A separate install used for Arduino sketches on the v5.x path —
        # the ONLY core that can build esp32c6 .ino sketches. Discovered
        # under the v5 install's components/ (or ARDUINO_ESP32_5_PATH).
        # Kept independent of the 2.x core so both remain available and the
        # pipeline picks per build.
        self.arduino5_path = os.environ.get('ARDUINO_ESP32_5_PATH', '')
        if not self.arduino5_path:
            for candidate in [
                r'C:\Espressif5.5\components\arduino-esp32',
                (os.path.join(os.path.dirname(self.idf5_path), '..',
                              'components', 'arduino-esp32')
                 if self.idf5_path else ''),
                '/opt/arduino-esp32-3',
            ]:
                if candidate and os.path.isdir(candidate):
                    self.arduino5_path = os.path.abspath(candidate)
                    break
        self.has_arduino5 = (
            bool(self.arduino5_path) and os.path.isdir(self.arduino5_path)
        )
        if self.has_arduino5:
            logger.info(f'[espidf] arduino-esp32 3.x core (IDF5): {self.arduino5_path}')
        else:
            logger.info('[espidf] arduino-esp32 3.x core: no (C6 .ino unavailable)')

    @property
    def available(self) -> bool:
        """Whether ESP-IDF toolchain is available."""
        return bool(self.idf_path) and os.path.isdir(self.idf_path)

    # Targets that only exist in ESP-IDF v5.x — the pinned v4.4.7 tree
    # predates them, so they build against idf5_path instead of idf_path.
    _IDF5_TARGETS: frozenset[str] = frozenset({'esp32c6', 'esp32p4', 'esp32c5'})

    # Flash offset where each chip's boot ROM expects the 2nd-stage
    # bootloader. ESP32 / ESP32-S2 use 0x1000; every newer chip (S3, C2,
    # C3, C6, H2) boots from 0x0, so that is the default for unlisted
    # targets. (A future P4/C5 entry would be 0x2000.)
    _BOOTLOADER_OFFSETS: dict[str, int] = {
        'esp32': 0x1000,
        'esp32s2': 0x1000,
        'esp32p4': 0x2000,
        'esp32c5': 0x2000,
    }

    # The esp-hosted-mcu sync-RPC race, fixed at source.
    #
    # Upstream 2.12.12 mints RPC uids and claims sync-response table slots
    # with no locking. Two tasks issuing sync RPCs in the same instant
    # cross-wire: the losing waiter re-reads a slot the winner already
    # cleared and asserts inside hosted_destroy_semaphore(NULL), which
    # panics the core the Arduino event task runs on -- so a P4 sketch
    # associates, gets a DHCP lease, and never sees WL_CONNECTED. Real
    # boards dodge it by jitter; the deterministic engine hits it every
    # run (project/espressif-devkits-2026-08/STATUS.md, 2026-08-26, and
    # patches/esp-hosted-2.12.12-sync-rpc-race.patch in that directory).
    #
    # Managed components are hash-checked and self-restoring, so the patch
    # cannot live in managed_components/. The component manager's own
    # documented escape hatch is a project-local copy in components/,
    # which overrides the managed one. This runs after the configure that
    # fetches dependencies; when it creates the override, the caller must
    # re-run configure so the build system picks the new component dir up.
    _ESP_HOSTED_RACE_FIXES: list[tuple[str, str]] = [
        (
            'static int set_async_resp_callback(ctrl_cmd_t *app_req,'
            ' rpc_rsp_cb_t resp_cb, void *timer_hdl);',
            'static int set_async_resp_callback(ctrl_cmd_t *app_req,'
            ' rpc_rsp_cb_t resp_cb, void *timer_hdl);\n'
            'static portMUX_TYPE velxio_sync_slot_mux ='
            ' portMUX_INITIALIZER_UNLOCKED;',
        ),
        (
            '\tuid++;\n'
            '\t// handle rollover in uid value\n'
            '\tif (!uid)\n'
            '\t\tuid++;\n'
            '\tapp_req->uid = uid;',
            '\tportENTER_CRITICAL(&velxio_sync_slot_mux);'
            ' /* Velxio: atomic uid mint */\n'
            '\tuid++;\n'
            '\t// handle rollover in uid value\n'
            '\tif (!uid)\n'
            '\t\tuid++;\n'
            '\tapp_req->uid = uid;\n'
            '\tportEXIT_CRITICAL(&velxio_sync_slot_mux);',
        ),
        (
            '\t\tfor (i = 0; i < MAX_SYNC_RPC_TRANSACTIONS; i++) {\n'
            '\t\t\tif (!sync_rsp_table[i].uid) {\n'
            '\t\t\t\tESP_LOGD(TAG, "Register sync sem %p for uid %ld",'
            ' app_req->rx_sem, app_req->uid);\n'
            '\t\t\t\tsync_rsp_table[i].uid = app_req->uid;\n'
            '\t\t\t\tsync_rsp_table[i].sem = app_req->rx_sem;\n'
            '\t\t\t\treturn CALLBACK_SET_SUCCESS;\n'
            '\t\t\t}\n'
            '\t\t}',
            '\t\t/* Velxio: claim the slot under the mux */\n'
            '\t\tportENTER_CRITICAL(&velxio_sync_slot_mux);\n'
            '\t\tfor (i = 0; i < MAX_SYNC_RPC_TRANSACTIONS; i++) {\n'
            '\t\t\tif (!sync_rsp_table[i].uid) {\n'
            '\t\t\t\tsync_rsp_table[i].uid = app_req->uid;\n'
            '\t\t\t\tsync_rsp_table[i].sem = app_req->rx_sem;\n'
            '\t\t\t\tportEXIT_CRITICAL(&velxio_sync_slot_mux);\n'
            '\t\t\t\tESP_LOGD(TAG, "Register sync sem %p for uid %ld",'
            ' app_req->rx_sem, app_req->uid);\n'
            '\t\t\t\treturn CALLBACK_SET_SUCCESS;\n'
            '\t\t\t}\n'
            '\t\t}\n'
            '\t\tportEXIT_CRITICAL(&velxio_sync_slot_mux);',
        ),
        (
            '\tfor (i = 0; i < MAX_SYNC_RPC_TRANSACTIONS; i++) {\n'
            '\t\tif (sync_rsp_table[i].uid == app_req->uid) {\n'
            '\t\t\tret = g_h.funcs->_h_get_semaphore(sync_rsp_table[i].sem,'
            ' SEC_TO_MILLISEC(timeout_sec));\n'
            '\t\t\tif (g_h.funcs->_h_destroy_semaphore(sync_rsp_table[i].sem)) {\n'
            '\t\t\t\tESP_LOGE(TAG, "read sem rx for resp[0x%x] destroy failed",'
            ' exp_resp_msg_id);\n'
            '\t\t\t}\n'
            '\t\t\t// clear table entry\n'
            '\t\t\tsync_rsp_table[i].uid = 0;\n'
            '\t\t\tsync_rsp_table[i].sem = NULL;\n'
            '\t\t\treturn ret;\n'
            '\t\t}\n'
            '\t}',
            '\t{\n'
            '\t\t/* Velxio: read under the mux, wait on a LOCAL copy,'
            ' clear before destroy */\n'
            '\t\tvoid *velxio_my_sem = NULL;\n'
            '\t\tportENTER_CRITICAL(&velxio_sync_slot_mux);\n'
            '\t\tfor (i = 0; i < MAX_SYNC_RPC_TRANSACTIONS; i++) {\n'
            '\t\t\tif (sync_rsp_table[i].uid == app_req->uid) {\n'
            '\t\t\t\tvelxio_my_sem = sync_rsp_table[i].sem;\n'
            '\t\t\t\tbreak;\n'
            '\t\t\t}\n'
            '\t\t}\n'
            '\t\tportEXIT_CRITICAL(&velxio_sync_slot_mux);\n'
            '\t\tif (velxio_my_sem) {\n'
            '\t\t\tret = g_h.funcs->_h_get_semaphore(velxio_my_sem,'
            ' SEC_TO_MILLISEC(timeout_sec));\n'
            '\t\t\tportENTER_CRITICAL(&velxio_sync_slot_mux);\n'
            '\t\t\tif (sync_rsp_table[i].uid == app_req->uid) {\n'
            '\t\t\t\tsync_rsp_table[i].uid = 0;\n'
            '\t\t\t\tsync_rsp_table[i].sem = NULL;\n'
            '\t\t\t}\n'
            '\t\t\tportEXIT_CRITICAL(&velxio_sync_slot_mux);\n'
            '\t\t\tif (g_h.funcs->_h_destroy_semaphore(velxio_my_sem)) {\n'
            '\t\t\t\tESP_LOGE(TAG, "read sem rx for resp[0x%x] destroy failed",'
            ' exp_resp_msg_id);\n'
            '\t\t\t}\n'
            '\t\t\treturn ret;\n'
            '\t\t}\n'
            '\t}',
        ),
        (
            '\tfor (i = 0; i < MAX_SYNC_RPC_TRANSACTIONS; i++) {\n'
            '\t\tif (sync_rsp_table[i].uid == app_resp->uid) {\n'
            '\t\t\treturn g_h.funcs->_h_post_semaphore(sync_rsp_table[i].sem);\n'
            '\t\t}\n'
            '\t}',
            '\t/* Velxio: post inside the mux so the waiter cannot'
            ' clear-and-destroy meanwhile */\n'
            '\tportENTER_CRITICAL(&velxio_sync_slot_mux);\n'
            '\tfor (i = 0; i < MAX_SYNC_RPC_TRANSACTIONS; i++) {\n'
            '\t\tif (sync_rsp_table[i].uid == app_resp->uid &&'
            ' sync_rsp_table[i].sem) {\n'
            '\t\t\tint velxio_post_ret ='
            ' g_h.funcs->_h_post_semaphore(sync_rsp_table[i].sem);\n'
            '\t\t\tportEXIT_CRITICAL(&velxio_sync_slot_mux);\n'
            '\t\t\treturn velxio_post_ret;\n'
            '\t\t}\n'
            '\t}\n'
            '\tportEXIT_CRITICAL(&velxio_sync_slot_mux);',
        ),
    ]

    def _override_esp_hosted_with_race_fix(self, project_dir: Path) -> bool:
        """Create the patched components/ override for esp_hosted.

        Returns True when the override was CREATED this call (the caller
        must re-run cmake configure so the new component dir is picked up);
        False when it already exists or there is nothing to patch.
        """
        managed = project_dir / 'managed_components' / 'espressif__esp_hosted'
        override = project_dir / 'components' / 'espressif__esp_hosted'
        if override.exists():
            return False
        if not managed.exists():
            return False

        rpc_core = (
            managed / 'host' / 'drivers' / 'rpc' / 'core' / 'rpc_core.c'
        )
        try:
            source = rpc_core.read_text(encoding='utf-8')
        except OSError:
            logger.warning('[espidf] esp_hosted override: rpc_core.c unreadable')
            return False

        for old, _new in self._ESP_HOSTED_RACE_FIXES:
            if old not in source:
                # A different esp_hosted version: the anchors moved. Do NOT
                # guess -- build unpatched and say so, loudly, so the pin
                # bump gets a deliberate re-port instead of a silent no-op.
                logger.warning(
                    '[espidf] esp_hosted race patch anchors not found — '
                    'component version changed? building UNPATCHED'
                )
                return False

        override.parent.mkdir(exist_ok=True)
        shutil.copytree(managed, override)
        for old, new in self._ESP_HOSTED_RACE_FIXES:
            source = source.replace(old, new, 1)
        (override / 'host' / 'drivers' / 'rpc' / 'core' / 'rpc_core.c').write_text(
            source, encoding='utf-8'
        )
        # The hash file belongs to the managed copy's lifecycle, not ours.
        (override / '.component_hash').unlink(missing_ok=True)
        logger.info('[espidf] esp_hosted sync-RPC race patch applied (components/ override)')
        return True

    def _is_esp32c3(self, board_fqbn: str) -> bool:
        """Return True if FQBN targets ESP32-C3 (RISC-V).

        Lowercased like every sibling below, and for a reason this one learned
        the hard way: `esp32:esp32:XIAO_ESP32C3` is spelled in capitals, so the
        case-sensitive test missed it, the target fell through to 'esp32', and
        a RISC-V board was handed the Xtensa toolchain. It failed loudly here
        (a missing HWCDCSerial), but the class of bug is the silent one.
        """
        f = board_fqbn.lower()
        return 'esp32c3' in f or 'esp32-c3' in f

    def _is_esp32c6(self, board_fqbn: str) -> bool:
        """Return True if FQBN targets ESP32-C6 (RISC-V, IDF v5.x only)."""
        f = board_fqbn.lower()
        return 'esp32c6' in f or 'esp32-c6' in f

    def _is_esp32p4(self, board_fqbn: str) -> bool:
        """Return True if FQBN targets ESP32-P4 (RISC-V, IDF v5.x only)."""
        f = board_fqbn.lower()
        return 'esp32p4' in f or 'esp32-p4' in f

    def _is_esp32c5(self, board_fqbn: str) -> bool:
        """Return True if FQBN targets ESP32-C5 (RISC-V, IDF v5.x only)."""
        f = board_fqbn.lower()
        return 'esp32c5' in f or 'esp32-c5' in f

    def _idf_root(self, use_idf5: bool) -> str:
        """The ESP-IDF tree a compile builds against."""
        return self.idf5_path if use_idf5 else self.idf_path

    def _use_idf5(self, idf_target: str, arduino_mode: bool) -> bool:
        """Decide which IDF major this compile builds against.

        Policy: IDF v5.x is THE toolchain for the whole ESP32 family
        (esp32 / s2 / s3 / c3 / c6); the pinned v4.4.7 tree is legacy.

        - esp32c6 only exists in v5.x → always v5.
        - Arduino-as-component builds are tied to the core's IDF. When an
          arduino-esp32 3.x core (IDF 5.x based — 3.3.x pairs with IDF
          5.5) is installed, Arduino sketches build on v5 with it. Without
          a 3.x core they FALL BACK to v4.4.7 + the 2.x core (which is IDF
          4.4-based). Escape hatches: VELXIO_ARDUINO_IDF5=0 forces the
          v4.4 path even when a 3.x core exists; =1 forces v5.
        - Pure-IDF builds (user code defines app_main) use v5 whenever the
          v5 install exists, and fall back to v4.4 when it doesn't (OSS
          self-host without the v5 install).
        """
        if idf_target in self._IDF5_TARGETS:
            return True
        has_idf5 = bool(self.idf5_path) and os.path.isdir(self.idf5_path)
        if arduino_mode:
            override = os.environ.get('VELXIO_ARDUINO_IDF5', '')
            if override in ('1', 'true', 'True'):
                return has_idf5
            if override in ('0', 'false', 'False'):
                return False
            # Auto: prefer v5 + the 3.x core when both are present.
            return has_idf5 and self.has_arduino5
        return has_idf5

    def _arduino_path_for(self, use_idf5: bool) -> str:
        """The arduino-esp32 core a build uses: the 3.x core on v5, the
        2.x core on v4.4 — falling back to whichever exists if the
        preferred one is absent."""
        if use_idf5:
            return self.arduino5_path or self.arduino_path
        return self.arduino_path or self.arduino5_path

    def _arduino_supports_target(self, idf_target: str) -> bool:
        """True when SOME installed arduino-esp32 core can build this IDF
        target as Arduino-as-component.

        IDF5-only targets (esp32c6) need an arduino-esp32 3.x core (IDF
        5.x based) — the 2.x core has no such target. Classic targets
        (esp32/s2/s3/c3) build with either core. When no usable core
        exists for the target the sketch is refused with a structured
        error rather than being pattern-translated into something it
        isn't.
        """
        if idf_target == 'esp32c5':
            # No arduino-esp32 core supports the C5 yet — IDF-native only.
            return False
        if idf_target in self._IDF5_TARGETS:
            return self.has_arduino5
        return self.has_arduino or self.has_arduino5

    def _arduino_core_version(self, arduino_path: Optional[str] = None) -> Optional[str]:
        """Best-effort version of an arduino-esp32 core (package.json
        ``version``), for user-facing messages. Defaults to the 2.x core."""
        path = arduino_path or self.arduino_path
        if not path:
            return None
        try:
            with open(
                os.path.join(path, 'package.json'), encoding='utf-8'
            ) as fh:
                return json.load(fh).get('version')
        except (OSError, ValueError):
            return None

    @staticmethod
    def _contains_app_main(code: str) -> bool:
        """True when the code defines its own ESP-IDF entry point
        (``void app_main(void)``) — i.e. it is a plain ESP-IDF program
        rather than an Arduino setup()/loop() sketch."""
        return bool(re.search(r'\bvoid\s+app_main\s*\(', code))

    def _is_esp32s3(self, board_fqbn: str) -> bool:
        """Return True if FQBN targets ESP32-S3 (Xtensa LX7).

        Most S3 FQBNs contain 'esp32s3' (esp32s3, XIAO_ESP32S3 uppercase — the
        lowercased substring test still matches), but a few S3 boards use a
        variant name that doesn't: Arduino Nano ESP32 = nano_nora, M5 Cardputer/
        StampS3 = m5stack_cardputer / m5stack_stamps3, so those are matched
        explicitly. Without this every S3 board compiled for the 'esp32' (LX6)
        target and could not boot the esp32s3 QEMU machine.
        """
        f = board_fqbn.lower()
        if 'esp32s3' in f:
            return True
        return any(v in f for v in ('nano_nora', 'm5stack_cardputer', 'm5stack_stamps3', 'm5stamp_s3'))

    # Cache: boards.txt is a few hundred KB and never changes at runtime.
    _variant_cache: dict = {}

    @staticmethod
    def _fqbn_board_id_and_options(board_fqbn: str) -> tuple[str, dict]:
        """Split an arduino FQBN into (board_id, menu-option dict).

        arduino-cli syntax: ``vendor:arch:board_id[:Menu1=val1,Menu2=val2]``.
        The espidf lane must understand the 4-part option-suffix form too,
        not just plain 3-part FQBNs — the C3-LCDkit board def pins
        ``CDCOnBoot=cdc`` this way (the real kit has no UART bridge; its only
        console is the USB Serial/JTAG port). Menu keys a caller does not
        recognise are simply ignored.
        """
        parts = board_fqbn.split(':')
        opts: dict = {}
        if len(parts) >= 4 and parts[3]:
            for kv in parts[3].split(','):
                if '=' in kv:
                    k, v = kv.split('=', 1)
                    opts[k.strip()] = v.strip()
            board_id = parts[2]
        else:
            board_id = parts[-1]
        return board_id.split('?')[0].strip(), opts

    def _arduino_variant(self, board_fqbn: str, idf_target: str) -> str:
        """The Arduino VARIANT for this FQBN, from arduino-esp32's boards.txt.

        Without this every board builds against ``variants/<chip>/``, i.e. as a
        generic dev-kit, and the board's own pin names never exist: a XIAO
        sketch dies on ``D1``, an M5 sketch on its silk names. Since those are
        exactly the sketches people copy from vendor wikis, the emulator has to
        get this right to be believable.

        boards.txt is the authority (``<board>.build.variant=<variant>``), so it
        is read rather than guessed; anything not found falls back to the chip,
        which is the previous behaviour.
        """
        board_id, _ = self._fqbn_board_id_and_options(board_fqbn)
        if not board_id:
            return idf_target
        key = (board_id, idf_target)
        if key in self._variant_cache:
            return self._variant_cache[key]

        variant = idf_target
        # The 3.x core first: it is the one the IDF5 targets build against.
        roots = [
            r
            for r in (
                os.environ.get('ARDUINO_ESP32_V3_PATH', '/opt/arduino-esp32-3'),
                os.environ.get('ARDUINO_ESP32_PATH', '/opt/arduino-esp32'),
            )
            if r
        ]
        for root in roots:
            boards_txt = Path(root) / 'boards.txt'
            if not boards_txt.is_file():
                continue
            try:
                text = boards_txt.read_text(encoding='utf-8', errors='ignore')
            except OSError:
                continue
            needle = f'{board_id}.build.variant='
            for line in text.splitlines():
                if line.startswith(needle):
                    found = line.split('=', 1)[1].strip()
                    if found:
                        variant = found
                    break
            if variant != idf_target:
                break

        if variant == idf_target and board_id != idf_target:
            logger.info(
                f'[espidf] no build.variant for {board_id} in boards.txt; '
                f'falling back to {idf_target}'
            )
        self._variant_cache[key] = variant
        return variant

    _board_flags_cache: dict = {}

    def _arduino_board_flags(self, board_fqbn: str) -> dict:
        """USB/identity flags for this FQBN from arduino-esp32's boards.txt.

        Returns {'board': str|None, 'cdc_on_boot': bool}:
        - ``board``: the ``<id>.build.board`` name — arduino-cli defines
          ``ARDUINO_<board>`` from it and vendor sketches #ifdef on it.
        - ``cdc_on_boot``: ``<id>.build.cdc_on_boot=1`` — on real hardware
          ``Serial`` is then the USB CDC, not UART0. Boards like the XIAO
          ESP32S3 expose UART0's default RX pin (GPIO44) as a plain Dx pin,
          so building them with Serial on UART0 is not just unfaithful: a
          pinMode() on that pin tears the UART driver down mid-sketch.

        A ``CDCOnBoot`` menu option in the FQBN suffix overrides the board's
        boards.txt default, mirroring arduino-cli
        (``<id>.menu.CDCOnBoot.cdc.build.cdc_on_boot=1``): the C3-LCDkit pins
        ``esp32:esp32:esp32c3:CDCOnBoot=cdc`` so its console matches the real
        kit, which only exposes the USB Serial/JTAG port.
        """
        board_id, menu_opts = self._fqbn_board_id_and_options(board_fqbn)
        if board_id in self._board_flags_cache:
            return self._apply_menu_overrides(self._board_flags_cache[board_id], menu_opts)
        flags = {'board': None, 'cdc_on_boot': False}
        roots = [
            r
            for r in (
                os.environ.get('ARDUINO_ESP32_V3_PATH', '/opt/arduino-esp32-3'),
                os.environ.get('ARDUINO_ESP32_PATH', '/opt/arduino-esp32'),
            )
            if r
        ]
        for root in roots:
            boards_txt = Path(root) / 'boards.txt'
            if not boards_txt.is_file():
                continue
            try:
                text = boards_txt.read_text(encoding='utf-8', errors='ignore')
            except OSError:
                continue
            for line in text.splitlines():
                if line.startswith(f'{board_id}.build.board='):
                    flags['board'] = line.split('=', 1)[1].strip() or None
                elif line.startswith(f'{board_id}.build.cdc_on_boot='):
                    flags['cdc_on_boot'] = line.split('=', 1)[1].strip() == '1'
            if flags['board'] is not None:
                break
        self._board_flags_cache[board_id] = flags
        return self._apply_menu_overrides(flags, menu_opts)

    @staticmethod
    def _apply_menu_overrides(flags: dict, menu_opts: dict) -> dict:
        """Overlay FQBN menu options on the boards.txt base flags.

        Only ``CDCOnBoot`` is understood today (``cdc`` -> 1, ``default`` ->
        the boards.txt value). Returns a copy so the per-board cache never
        holds an override.
        """
        cdc = menu_opts.get('CDCOnBoot')
        if cdc == 'cdc':
            return {**flags, 'cdc_on_boot': True}
        return flags

    def _idf_target(self, board_fqbn: str) -> str:
        """Map FQBN to IDF_TARGET."""
        if self._is_esp32c3(board_fqbn):
            return 'esp32c3'
        if self._is_esp32c6(board_fqbn):
            return 'esp32c6'
        if self._is_esp32s3(board_fqbn):
            return 'esp32s3'
        if self._is_esp32p4(board_fqbn):
            return 'esp32p4'
        if self._is_esp32c5(board_fqbn):
            return 'esp32c5'
        # Default to esp32 (Xtensa LX6) for the original ESP32 / ESP32-S2
        return 'esp32'

    def _sync_managed_components(self, project_dir: Path, deps: dict) -> bool:
        """Declare extra ESP-IDF managed components for the `main` component.

        The template ships no idf_component.yml, so every managed component the
        build sees today arrives transitively through arduino-esp32's own
        manifest. Anything it does not depend on has to be asked for explicitly;
        the component manager then fetches it into managed_components/ during the
        cmake configure and caches it in the build dir for later runs.

        Returns True when the manifest differs from the previous build's in
        this dir (created, removed, or other components). The caller MUST then
        run the configure explicitly: the component manager only fetches during
        a configure, and ninja's RERUN_CMAKE rule lists the manifests that
        existed at the LAST configure - a manifest created after it is not an
        input ninja knows about, so a warm dir would go straight to compiling
        and die on "esp_camera.h: No such file or directory" with the
        dependency declared right there in the log (2026-09-05, XIAO ESP32S3).
        When the bytes match, the manifest gets its previous mtime back so a
        warm camera variant skips the configure like a bare one does.
        """
        manifest = project_dir / 'main' / 'idf_component.yml'
        stash = project_dir / _MANIFEST_STASH
        if not deps:
            # prepare restored main/ from the template, which ships no
            # manifest; one present here is the user's own (pure-IDF mode
            # writes their files into main/ by name). Report whether the
            # previous build's manifest differs from this one, or existed.
            if manifest.is_file():
                return _restore_mtime_if_unchanged(manifest, stash)
            return stash.is_file()
        lines = ['# Auto-generated by Velxio — components the sketch needs that the',
                 '# Arduino core does not pull in by itself.',
                 'dependencies:']
        for name in sorted(deps):
            lines.append(f'  {name}: "{deps[name]}"')
        manifest.write_text('\n'.join(lines) + '\n', encoding='utf-8')
        changed = _restore_mtime_if_unchanged(manifest, stash)
        logger.info(
            '[espidf] Declared managed components: %s%s',
            ', '.join(sorted(deps)),
            ' (new for this build dir; configure required)' if changed else '',
        )
        return changed

    def _component_graph_token(self, code: str) -> str:
        """Components the sketch pulls into the ESP-IDF graph by #include:
        registry (managed) components and IDF-tree components main must
        REQUIRE. Folded into the build-dir identity so a camera sketch never
        shares a configured build/ with a bare one; '' when there are none,
        which keeps every existing variant's hash as it was."""
        managed = sorted(self._detect_managed_components(code))
        idf_comps = sorted(self._detect_idf_components(code))
        if not managed and not idf_comps:
            return ''
        return 'mc:' + ','.join(managed) + '|ic:' + ','.join(idf_comps)

    # include -> managed component (name, version). Each of these headers
    # ships in a registry component that neither the template nor
    # arduino-esp32's own manifest depends on, so a sketch using it dies
    # with "No such file or directory" unless the dependency is declared
    # (the esp_camera.h lesson, generalized for the Espressif devkit
    # boards' display/touch stacks).
    _MANAGED_COMPONENT_INCLUDES: tuple[tuple[str, str, str], ...] = (
        (r'esp_camera\.h', 'espressif/esp32-camera', '^2.0.4'),
        (r'esp_lcd_st77916\.h', 'espressif/esp_lcd_st77916', '*'),
        (r'esp_lcd_touch_cst816s\.h', 'espressif/esp_lcd_touch_cst816s', '*'),
        (r'esp_lcd_gc9a01\.h', 'espressif/esp_lcd_gc9a01', '*'),
        (r'esp_lcd_ek79007\.h', 'espressif/esp_lcd_ek79007', '*'),
        # The building blocks Espressif's OWN board demos are made of — the
        # C3-LCDkit knob_panel drives its WS2812 through led_strip and its
        # EC11 through knob+button, the P4 devkit's panel is a GT911, and
        # every audio demo on the VoCat/P4 goes through esp_codec_dev. A
        # visitor pasting official example code hit "No such file or
        # directory" on all four.
        (r'led_strip\.h', 'espressif/led_strip', '*'),
        (r'iot_button\.h', 'espressif/button', '*'),
        (r'iot_knob\.h', 'espressif/knob', '*'),
        (r'esp_lcd_touch_gt911\.h', 'espressif/esp_lcd_touch_gt911', '*'),
        (r'esp_codec_dev\.h', 'espressif/esp_codec_dev', '*'),
        # LVGL and its BSP glue: every official board demo's UI is built on
        # them, so without these a visitor cannot paste a single screen of
        # esp-dev-kits code. The dependency is only declared when the source
        # includes the header, so nothing else pays for the bigger build.
        (r'lvgl\.h', 'lvgl/lvgl', '*'),
        (r'esp_lvgl_port\.h', 'espressif/esp_lvgl_port', '*'),
    )

    def _strip_comments(self, code: str) -> str:
        """A commented-out #include is not an include (same rule the library
        scanner applies); without this a `// #include "esp_camera.h"` left in
        a sketch fetched the camera component and, now, cost the sketch its
        own build variant."""
        code = self._PP_COMMENT_BLOCK_RE.sub(' ', code)
        return self._PP_COMMENT_LINE_RE.sub(' ', code)

    def _detect_managed_components(self, code: str) -> dict:
        """Managed components the source explicitly #includes."""
        code = self._strip_comments(code)
        deps: dict[str, str] = {}
        for pattern, name, version in self._MANAGED_COMPONENT_INCLUDES:
            if re.search(r'#include\s*[<"]' + pattern + r'[">]', code):
                deps[name] = version
        return deps

    @staticmethod
    def _without_merged_duplicates(deps: dict, merged_libs: dict | None) -> dict:
        """One library, one copy.

        A registry component and an Arduino library can be the same project:
        `lvgl/lvgl` and the LVGL a user installs from the Library Manager are.
        Declaring both puts two copies of it in the build, each with its own
        include root, and then `#include <lvgl.h>` in the sketch resolves to
        whichever path comes first while the project's `lv_conf.h` configures
        the other one — the sketch and the library compiled against different
        configurations, which is exactly as broken as it sounds (issue #352).

        The installed Arduino library wins. It is the one the user chose, the
        one their config header is written for, and the one arduino-cli would
        have used. The registry copy is only there to cover headers nobody
        installed.
        """
        if not deps or not merged_libs:
            return deps
        norm = lambda n: n.lower().replace('-', '_').replace(' ', '_')
        have = {norm(name) for name in merged_libs.values()}
        kept: dict = {}
        for dep, version in deps.items():
            if norm(dep.split('/')[-1]) in have:
                logger.info(
                    '[espidf] %s is installed as an Arduino library — not also '
                    'fetching the registry component', dep
                )
                continue
            kept[dep] = version
        return kept

    # IDF components that ship INSIDE the IDF tree (not the registry) and are
    # NOT on an Arduino sketch's include path by default. arduino-esp32 3.x
    # keeps most of its requires PRIVATE, so a sketch that includes one of
    # these dies with "No such file or directory" while the very same header
    # resolves fine from a user library (whose merged component requires it).
    # Hit while writing the ESP32-S3-EYE camera example: esp_lcd_panel_io.h
    # compiled only when an unrelated Adafruit library happened to be present.
    _IDF_COMPONENT_INCLUDES: tuple[tuple[str, str], ...] = (
        (r'esp_lcd_panel_io\.h', 'esp_lcd'),
        (r'esp_lcd_panel_ops\.h', 'esp_lcd'),
        (r'esp_lcd_panel_vendor\.h', 'esp_lcd'),
        (r'esp_lcd_types\.h', 'esp_lcd'),
        (r'esp_lcd_mipi_dsi\.h', 'esp_lcd'),
        (r'esp_cache\.h', 'esp_mm'),
        (r'esp_ldo_regulator\.h', 'esp_hw_support'),
        (r'esp_psram\.h', 'esp_psram'),
    )

    def _detect_idf_components(self, code: str) -> list[str]:
        """IDF-tree components the source #includes, that exist in this IDF."""
        code = self._strip_comments(code)
        wanted: list[str] = []
        for pattern, comp in self._IDF_COMPONENT_INCLUDES:
            if comp in wanted:
                continue
            if not re.search(r'#include\s*[<"]' + pattern + r'[">]', code):
                continue
            if self.idf_path and os.path.isdir(
                os.path.join(self.idf_path, 'components', comp)
            ):
                wanted.append(comp)
        return wanted

    def _detect_camera_usage(self, code: str) -> bool:
        """Does the sketch use the ESP32 camera driver?

        `esp_camera.h` does NOT ship with the Arduino core: it lives in the
        `espressif/esp32-camera` managed component, which arduino-esp32's own
        idf_component.yml does not depend on. So a camera sketch compiles fine
        everywhere else and dies here with "esp_camera.h: No such file or
        directory" — which is exactly what both ESP32-CAM examples did.
        """
        return bool(re.search(r'#include\s*[<"]esp_camera\.h[">]', code))

    def _detect_wifi_usage(self, code: str) -> bool:
        """Check if sketch uses WiFi."""
        return bool(re.search(r'#include\s*[<"]WiFi\.h[">]|WiFi\.begin\(', code))

    def _detect_idf_wifi_usage(self, code: str) -> bool:
        """Pure ESP-IDF mode: does the project use the esp_wifi stack?"""
        return bool(re.search(r'#include\s*[<"]esp_wifi\.h[">]|esp_wifi_init\s*\(', code))

    def _normalize_wifi_for_qemu_idf(self, code: str) -> str:
        """
        Pure ESP-IDF variant of _normalize_wifi_for_qemu. IDF projects set
        credentials via `#define WIFI_SSID "..."` or wifi_config_t designated
        initializers (`.ssid = "..."`, `.password = "..."`). Rewrite the
        common literal forms so the firmware associates with the open AP the
        QEMU fork broadcasts (_QEMU_WIFI_SSID); anything more dynamic
        (strcpy into the struct at runtime) is left alone and simply won't
        connect.
        """
        code = re.sub(
            r'(#define\s+\w*SSID\w*\s+)"[^"]*"',
            rf'\1"{_QEMU_WIFI_SSID}"',
            code,
            flags=re.IGNORECASE,
        )
        code = re.sub(
            r'(#define\s+\w*(?:PASS|PASSWORD|PSK)\w*\s+)"[^"]*"',
            r'\1""',
            code,
            flags=re.IGNORECASE,
        )
        code = re.sub(r'(\.ssid\s*=\s*)"[^"]*"', rf'\1"{_QEMU_WIFI_SSID}"', code)
        code = re.sub(r'(\.password\s*=\s*)"[^"]*"', r'\1""', code)
        return code

    def _detect_webserver_usage(self, code: str) -> bool:
        """Check if sketch uses WebServer."""
        return bool(re.search(
            r'#include\s*[<"]WebServer\.h[">]|#include\s*[<"]ESP8266WebServer\.h[">]|WebServer\s+\w+',
            code
        ))

    def _normalize_wifi_for_qemu(self, code: str) -> str:
        """
        Normalize WiFi SSID/password/channel in Arduino sketches for QEMU.

        QEMU's WiFi AP broadcasts _QEMU_WIFI_SSID on _QEMU_WIFI_CHANNEL with open auth.
        This method rewrites the user's sketch so that:
          - Any SSID string literal → _QEMU_WIFI_SSID
          - Password → "" (open auth)
          - Channel → _QEMU_WIFI_CHANNEL
        The user's editor still shows their original code; only the compiled
        binary is modified.
        """
        if not self._detect_wifi_usage(code):
            return code

        # 1) Replace SSID variable definitions:
        #    const char* ssid = "anything" → _QEMU_WIFI_SSID
        #    char ssid[] = "anything"      → _QEMU_WIFI_SSID
        #    #define WIFI_SSID "anything"   → _QEMU_WIFI_SSID
        code = re.sub(
            r'((?:const\s+)?char\s*\*?\s*ssid\s*\[?\]?\s*=\s*)"[^"]*"',
            rf'\1"{_QEMU_WIFI_SSID}"',
            code,
            flags=re.IGNORECASE
        )
        code = re.sub(
            r'(#define\s+\w*SSID\w*\s+)"[^"]*"',
            rf'\1"{_QEMU_WIFI_SSID}"',
            code,
            flags=re.IGNORECASE
        )

        # 2) Normalize WiFi.begin() calls:
        #    WiFi.begin("X")           → WiFi.begin(_QEMU_WIFI_SSID, "", _QEMU_WIFI_CHANNEL)
        #    WiFi.begin("X", "pass")   → WiFi.begin(_QEMU_WIFI_SSID, "", _QEMU_WIFI_CHANNEL)
        #    WiFi.begin(ssid, pass, N) → WiFi.begin(ssid, "", _QEMU_WIFI_CHANNEL)
        #    WiFi.begin(ssid)          → WiFi.begin(ssid, "", _QEMU_WIFI_CHANNEL)

        def _rewrite_wifi_begin(m: re.Match) -> str:
            args = m.group(1)
            parts = [a.strip() for a in args.split(',')]
            ssid_arg = parts[0]
            # If SSID is a string literal, force to _QEMU_WIFI_SSID
            if ssid_arg.startswith('"'):
                ssid_arg = f'"{_QEMU_WIFI_SSID}"'
            return f'WiFi.begin({ssid_arg}, "", {_QEMU_WIFI_CHANNEL})'

        code = re.sub(
            r'WiFi\.begin\s*\(([^)]+)\)',
            _rewrite_wifi_begin,
            code
        )

        logger.info('[espidf] WiFi normalized: SSID→%s, channel→%d, open auth', _QEMU_WIFI_SSID, _QEMU_WIFI_CHANNEL)
        return code

    def _translate_sketch_to_espidf(self, sketch_code: str) -> str:
        """
        Translate an Arduino WiFi+WebServer sketch to pure ESP-IDF C code.

        This handles the common pattern:
          - WiFi.begin("ssid", "pass") → esp_wifi_start() with static IP
          - WebServer server(80) + server.on("/", handler) → esp_http_server
          - digitalWrite/pinMode → gpio_set_level/gpio_set_direction

        Returns C source code for sketch_translated.c
        """
        uses_wifi = self._detect_wifi_usage(sketch_code)
        uses_webserver = self._detect_webserver_usage(sketch_code)

        # Extract route handlers from server.on() calls
        routes = []
        handler_bodies = {}
        if uses_webserver:
            # Match: server.on("/path", handler_func)
            # or:    server.on("/path", HTTP_GET, handler_func)
            for m in re.finditer(
                r'server\.on\(\s*"([^"]+)"\s*,\s*(?:HTTP_\w+\s*,\s*)?(\w+)\s*\)',
                sketch_code
            ):
                routes.append((m.group(1), m.group(2)))

            # Extract handler function bodies
            # Match: void handler_name() { ... server.send(...) ... }
            handler_bodies = {}
            for m in re.finditer(
                r'void\s+(\w+)\s*\(\s*\)\s*\{([^}]*(?:\{[^}]*\}[^}]*)*)\}',
                sketch_code,
                re.DOTALL
            ):
                fname = m.group(1)
                body = m.group(2)
                # Extract server.send() content
                send_match = re.search(
                    r'server\.send\s*\(\s*(\d+)\s*,\s*"([^"]+)"\s*,\s*"([^"]*)"',
                    body
                )
                if not send_match:
                    # Try multi-line string or variable
                    send_match = re.search(
                        r'server\.send\s*\(\s*(\d+)\s*,\s*"([^"]+)"\s*,\s*(\w+)',
                        body
                    )
                if send_match:
                    handler_bodies[fname] = {
                        'status': send_match.group(1),
                        'content_type': send_match.group(2),
                        'content': send_match.group(3),
                    }

        # Build the translated C source
        lines = []
        lines.append('/* Auto-translated from Arduino sketch to ESP-IDF */')
        lines.append('')

        if uses_wifi:
            lines.append(f'#define WIFI_SSID "{_QEMU_WIFI_SSID}"')
            lines.append('#define WIFI_PASS ""')
            lines.append(f'#define STATIC_IP "{_STATIC_IP}"')
            lines.append(f'#define GATEWAY_IP "{_GATEWAY_IP}"')
            lines.append(f'#define NETMASK "{_NETMASK}"')
            lines.append('')

        # Generate HTML content variables from handler bodies
        for fname, info in handler_bodies.items():
            content = info['content']
            if content.startswith('"') or content.startswith("'"):
                content = content.strip('"').strip("'")
            lines.append(f'static const char *{fname}_html = "{content}";')
        lines.append('')

        # Generate ESP-IDF HTTP handlers
        if uses_webserver:
            for path, handler_name in routes:
                info = handler_bodies.get(handler_name, {})
                ct = info.get('content_type', 'text/html')
                lines.append(f'static esp_err_t {handler_name}_handler(httpd_req_t *req) {{')
                lines.append(f'    httpd_resp_set_type(req, "{ct}");')
                if handler_name in handler_bodies:
                    lines.append(f'    return httpd_resp_send(req, {handler_name}_html, HTTPD_RESP_USE_STRLEN);')
                else:
                    lines.append(f'    return httpd_resp_send(req, "OK", 2);')
                lines.append('}')
                lines.append('')

        # Generate webserver start function
        if uses_webserver:
            lines.append('static void start_webserver(void) {')
            lines.append('    httpd_config_t config = HTTPD_DEFAULT_CONFIG();')
            lines.append('    httpd_handle_t server = NULL;')
            lines.append('    if (httpd_start(&server, &config) == ESP_OK) {')
            for path, handler_name in routes:
                uri_var = handler_name + '_uri'
                lines.append(f'        httpd_uri_t {uri_var} = {{')
                lines.append(f'            .uri = "{path}",')
                lines.append(f'            .method = HTTP_GET,')
                lines.append(f'            .handler = {handler_name}_handler')
                lines.append(f'        }};')
                lines.append(f'        httpd_register_uri_handler(server, &{uri_var});')
            lines.append('    }')
            lines.append('}')
            lines.append('')

        # WiFi event handler + init
        if uses_wifi:
            lines.append('static EventGroupHandle_t s_wifi_event_group;')
            lines.append('#define WIFI_CONNECTED_BIT BIT0')
            lines.append('')
            lines.append('static void wifi_event_handler(void *arg, esp_event_base_t base,')
            lines.append('                               int32_t id, void *data) {')
            lines.append('    if (base == WIFI_EVENT && id == WIFI_EVENT_STA_START)')
            lines.append('        esp_wifi_connect();')
            lines.append('    else if (base == WIFI_EVENT && id == WIFI_EVENT_STA_DISCONNECTED)')
            lines.append('        esp_wifi_connect();')
            lines.append('    else if (base == IP_EVENT && id == IP_EVENT_STA_GOT_IP)')
            lines.append('        xEventGroupSetBits(s_wifi_event_group, WIFI_CONNECTED_BIT);')
            lines.append('}')
            lines.append('')
            lines.append('static void wifi_init_sta(void) {')
            lines.append('    s_wifi_event_group = xEventGroupCreate();')
            lines.append('    esp_netif_init();')
            lines.append('    esp_event_loop_create_default();')
            lines.append('    esp_netif_t *sta = esp_netif_create_default_wifi_sta();')
            lines.append('    esp_netif_dhcpc_stop(sta);')
            lines.append('    esp_netif_ip_info_t ip_info;')
            lines.append('    ip_info.ip.addr = ipaddr_addr(STATIC_IP);')
            lines.append('    ip_info.gw.addr = ipaddr_addr(GATEWAY_IP);')
            lines.append('    ip_info.netmask.addr = ipaddr_addr(NETMASK);')
            lines.append('    esp_netif_set_ip_info(sta, &ip_info);')
            lines.append('    wifi_init_config_t cfg = WIFI_INIT_CONFIG_DEFAULT();')
            lines.append('    esp_wifi_init(&cfg);')
            lines.append('    esp_event_handler_instance_register(WIFI_EVENT, ESP_EVENT_ANY_ID,')
            lines.append('        &wifi_event_handler, NULL, NULL);')
            lines.append('    esp_event_handler_instance_register(IP_EVENT, IP_EVENT_STA_GOT_IP,')
            lines.append('        &wifi_event_handler, NULL, NULL);')
            lines.append('    wifi_config_t wifi_config = {')
            lines.append('        .sta = {')
            lines.append('            .ssid = WIFI_SSID,')
            lines.append('            .password = WIFI_PASS,')
            lines.append('            .threshold.authmode = WIFI_AUTH_OPEN,')
            lines.append('        },')
            lines.append('    };')
            lines.append('    esp_wifi_set_mode(WIFI_MODE_STA);')
            lines.append('    esp_wifi_set_config(WIFI_IF_STA, &wifi_config);')
            lines.append('    esp_wifi_start();')
            lines.append('}')
            lines.append('')

        # app_main
        lines.append('void app_main(void) {')
        if uses_wifi:
            lines.append('    esp_err_t ret = nvs_flash_init();')
            lines.append('    if (ret == ESP_ERR_NVS_NO_FREE_PAGES || ret == ESP_ERR_NVS_NEW_VERSION_FOUND) {')
            lines.append('        nvs_flash_erase();')
            lines.append('        nvs_flash_init();')
            lines.append('    }')
            lines.append('    wifi_init_sta();')
            lines.append('    vTaskDelay(pdMS_TO_TICKS(3000));')
        if uses_webserver:
            lines.append('    start_webserver();')
        lines.append('    while (1) {')
        lines.append('        vTaskDelay(pdMS_TO_TICKS(1000));')
        lines.append('    }')
        lines.append('}')

        return '\n'.join(lines) + '\n'

    def _find_arduino_libraries_dir(self) -> Path | None:
        """Find the Arduino global user-libraries directory (installed via arduino-cli).

        """
        candidates: list[Path] = [
            Path.home() / 'Arduino' / 'libraries',
            Path.home() / 'Documents' / 'Arduino' / 'libraries',
            Path('/root/Arduino/libraries'),              # Docker / CI as root
            Path('/home/user/Arduino/libraries'),
            Path('/Arduino/libraries'),
        ]
        # Also check arduino-cli's data directory
        for base in [
            Path.home() / '.arduino15',
            Path('/root/.arduino15'),
            Path('/home/user/.arduino15'),
        ]:
            candidates.append(base / 'libraries')

        for c in candidates:
            if c.is_dir():
                logger.info(f'[espidf] Arduino libraries dir: {c}')
                return c
        logger.warning('[espidf] Arduino libraries dir not found')
        return None

    # Headers that will NEVER appear in any Arduino library directory:
    #   - C/C++ standard library headers
    #   - Arduino core API types compiled directly into arduino-esp32 (not installable)
    #
    # Everything else (Wire.h, SPI.h, WiFi.h, Adafruit_GFX.h, …) is resolved
    # dynamically: user-installed libs → IDF component; arduino-esp32 bundled
    # libs → skip (already compiled in); not found → warning.
    _BUILTIN_HEADERS = frozenset({
        # C standard library
        'math.h', 'stdint.h', 'stdio.h', 'stdlib.h', 'string.h', 'stdarg.h',
        'stddef.h', 'stdbool.h', 'float.h', 'limits.h', 'assert.h',
        'ctype.h', 'errno.h', 'inttypes.h', 'locale.h', 'setjmp.h',
        'signal.h', 'time.h', 'wchar.h', 'wctype.h',
        # C++ standard library wrappers and STL.
        # MUST be marked built-in — otherwise the user_libs bundler resolves
        # them against /root/Arduino/libraries/ArduinoSTL (an AVR-only
        # uClibc++ port) and drags in complex.cpp / vector.cpp / …, none of
        # which compile against ESP-IDF's libstdc++.
        'cstdint', 'cstddef', 'cstdio', 'cstdlib', 'cstring', 'cmath',
        'cassert', 'cctype', 'cerrno', 'cfloat', 'climits', 'clocale',
        'csetjmp', 'csignal', 'cstdarg', 'ctime', 'cwchar', 'cwctype',
        'cinttypes',
        'algorithm', 'array', 'atomic', 'bitset', 'chrono', 'codecvt',
        'complex', 'condition_variable', 'deque', 'exception', 'fstream',
        'functional', 'future', 'initializer_list', 'iomanip', 'ios',
        'iosfwd', 'iostream', 'istream', 'iterator', 'limits', 'list',
        'locale', 'map', 'memory', 'mutex', 'new', 'numeric', 'optional',
        'ostream', 'queue', 'random', 'ratio', 'regex', 'set', 'sstream',
        'stack', 'stdexcept', 'streambuf', 'string', 'string_view',
        'system_error', 'thread', 'tuple', 'type_traits', 'typeindex',
        'typeinfo', 'unordered_map', 'unordered_set', 'utility', 'valarray',
        'variant', 'vector', 'any',
        # Arduino core types — part of arduino-esp32 source, not installable libraries
        'Arduino.h', 'HardwareSerial.h', 'Stream.h', 'Print.h', 'WString.h',
        'pgmspace.h', 'IPAddress.h',
    })

    # Core arduino-esp32 bundled libraries — already compiled into the IDF component,
    # must NOT be duplicated as separate user_libs components.
    _CORE_ESP32_LIBS: frozenset[str] = frozenset({
        'Wire', 'SPI', 'WiFi', 'EEPROM', 'SD', 'FS',
        'LittleFS', 'SPIFFS', 'WebServer', 'HTTPClient',
        'WiFiClientSecure', 'BluetoothSerial', 'BLE',
        'Preferences', 'Update', 'Ticker',
    })

    # Headers that ship inside the arduino-esp32 core but don't live in a
    # standalone library dir (so _find_library_for_header can't resolve
    # them). They're already compiled into the core — pulled transitively
    # by WiFi/WebServer/etc. — so a "not found" warning for them is a
    # false positive. Treated as core-provided, not "may fail".
    _CORE_ESP32_HEADERS: frozenset[str] = frozenset({
        'Udp.h', 'IPAddress.h', 'Client.h', 'Server.h', 'Stream.h',
        'Print.h', 'Printable.h', 'WiFiUdp.h', 'WiFiClient.h',
        'WiFiServer.h', 'WiFiType.h', 'esp_wifi.h',
        # Platform headers that do NOT exist in the arduino-esp32 core, so
        # the core-tree scan can't discover them, yet carry names generic
        # enough that some random installed library owns a file by that
        # name. Resolving one drags that whole library into user_libs_all
        # and its sources then fail on THEIR own missing includes.
        #
        # Reported 2026-08-03 (nikas79): ESPAsyncWebServer includes <Hash.h>
        # (an ESP8266-core header, guarded for that platform) and the global
        # scan resolved it to `stemihexapod/src/Hash.h` — a hexapod-robot
        # library — whose Serial.cpp / Hash.cpp / Server.cpp /
        # BluetoothLowEnergy.cpp / ExpansionDriver.cpp then broke every
        # ESP32 build with errors naming libraries the user never installed.
        'Hash.h', 'Serial.h', 'HardwareSerial.h', 'WString.h',
        'WCharacter.h', 'binary.h', 'pins_arduino.h', 'Esp.h',
        # FreeRTOS kernel headers. ESP-IDF ships FreeRTOS and puts its
        # include dir on the path, so a library writing `#include <task.h>`
        # or `<FreeRTOS.h>` means IDF's. The qualified spelling
        # (freertos/FreeRTOS.h) is already dropped by the scan's slash rule;
        # the BARE one used to resolve against the shared cache, where the
        # only owners are an Arduino FreeRTOS port (wrong platform: ESP32
        # has its own) and, for FreeRTOS.h alone, ESP32 BLE Arduino. That is
        # how AsyncTCP's `#include <FreeRTOS.h>` pulled in esp32blearduino,
        # whose src/FreeRTOS.h then failed on 'ringbuf_type_t', breaking
        # every ESPAsyncWebServer build.
        'FreeRTOS.h', 'task.h', 'semphr.h', 'portmacro.h', 'projdefs.h',
        'event_groups.h', 'message_buffer.h', 'stream_buffer.h', 'timers.h',
        'portable.h', 'queue.h', 'croutine.h', 'mpu_wrappers.h',
        'StackMacros.h', 'stack_macros.h', 'deprecated_definitions.h',
    })

    # Config headers the PROJECT is meant to supply, never a library.
    #
    # LVGL's sources do `#include "lv_conf.h"` behind `#if !LV_CONF_SKIP`.
    # The include scan is textual and does not evaluate that guard, so the
    # header is queued even for a build that defines LV_CONF_SKIP=1 and will
    # never read it. Resolving it against the shared library dir then finds
    # whichever installed library vendors its own copy -- Adafruit LvGL Glue
    # ships one written for LVGL v7 -- and merges that ENTIRE library. Its
    # sources fail against the LVGL v8 that the sketch actually uses
    # ("lv_fs_drv_t has no member named 'user_data'", "'file_t' was not
    # declared"), so a sketch whose only LVGL include is <lvgl.h> dies with a
    # wall of errors naming a library the user never asked for. Same failure
    # shape as the Hash.h -> stemihexapod case above. Reported 2026-08-28.
    #
    # A project that DOES ship its own lv_conf.h is unaffected: sketch files
    # are copied into the build's own source dir and found there, not through
    # this library scan.
    _PROJECT_SUPPLIED_HEADERS: frozenset[str] = frozenset({
        'lv_conf.h', 'lv_drv_conf.h', 'user_config.h', 'user_setup.h',
        'sdkconfig.h', 'zconf.h',
    })

    # A library that finds an ESP-IDF Kconfig prefers it over the header the
    # project supplied — on a real IDF project that IS the right answer. Here
    # it is not: a library the user installed from the Arduino index is
    # configured the Arduino way, by a header next to the sketch, and it only
    # sees a Kconfig at all because we compile it inside an IDF component. So
    # when the project ships the header, the library is told to leave the
    # Kconfig alone. Each entry is the library's own documented escape hatch,
    # not a patch to its sources.
    _ARDUINO_CONFIG_WINS: dict[str, tuple[str, ...]] = {
        # LVGL includes lv_conf_kconfig.h unconditionally unless this is set,
        # and our sdkconfig carries its symbols half-filled: the build dies on
        # "LV_MEM_SIZE >= 2kB is required" with the user's lv_conf.h sitting
        # right there, unread (issue #352).
        'lv_conf.h': ('LV_KCONFIG_IGNORE',),
    }

    # ...and the general shape of one. Config headers are named by convention
    # across the whole Arduino ecosystem, and one live build showed SIX of
    # them being resolved against the shared library dir in a single compile
    # (sdkconfig.h, lv_conf.h, lv_conf_kconfig.h, lv_rt_thread_conf.h,
    # User_Config.h, zconf.h) — six chances to merge a library nobody asked
    # for.
    _CONFIG_HEADER_SUFFIXES: tuple[str, ...] = ('conf.h', 'config.h', '_setup.h')

    @classmethod
    def _is_project_config_header(cls, header: str) -> bool:
        """Is this a build-configuration header rather than a library API?

        Why skipping the library scan for these is SAFE rather than merely
        convenient: once a library is merged, its own headers are on the
        include path, so a config header shipped BY the library that asks for
        it resolves at compile time without any lookup. The lookup can
        therefore only ever pull in a DIFFERENT library — which for a config
        header is never what the project meant. If the header really is
        missing the compiler says so, naming it, instead of dying inside the
        sources of a library the sketch never mentioned.
        """
        name = Path(header).name.lower()
        return name in cls._PROJECT_SUPPLIED_HEADERS or name.endswith(
            cls._CONFIG_HEADER_SUFFIXES
        )

    # Basenames of C/C++ standard headers. A user library that ships a private
    # header with one of these names (e.g. LovyanGFX's src/lgfx/internal/
    # limits.h, algorithm.h, memory.h, alloca.h) must NOT put that directory on
    # the global -I path: doing so shadows the toolchain header for the WHOLE
    # build. Concretely, FreeRTOS/portmacro.h does `#include <limits.h>` inside
    # an `extern "C"` block (reached via Arduino.h), and if it resolves to
    # LovyanGFX's limits.h — which pulls the C++ <limits> — the compile dies
    # with "template specialization with C linkage". Libraries reach these
    # private headers through file-relative includes (`#include "../internal/
    # limits.h"`), so the directory is never needed on -I. See
    # `_generate_merged_component` where dirs holding these are excluded.
    _SHADOW_STD_HEADERS: frozenset[str] = frozenset({
        'limits.h', 'stdio.h', 'stdlib.h', 'string.h', 'math.h', 'assert.h',
        'ctype.h', 'errno.h', 'time.h', 'stddef.h', 'stdint.h', 'setjmp.h',
        'signal.h', 'locale.h', 'wchar.h', 'stdbool.h', 'stdarg.h', 'float.h',
        'algorithm.h', 'memory.h', 'alloca.h', 'new.h',
        # Not a C standard header, but the same shadowing mechanism: FastLED
        # ships a host-test stub `src/platforms/stub/Arduino.h`. With that dir
        # on the global -I, any OTHER merged library's `#include <Arduino.h>`
        # (e.g. U8g2lib.cpp) resolves to the stub instead of the arduino-esp32
        # core — 'yield' undeclared, and fl::string pollutes String overload
        # resolution inside the core's WString.h. FastLED itself only reaches
        # the stub via the file-relative "platforms/stub/Arduino.h", which
        # still resolves with the directory off -I.
        'arduino.h',
        # Same story with an IDF component header: IDF's esp_http_server.h
        # does #include <http_parser.h> (the http_parser component's enum
        # with HTTP_GET/HTTP_POST/...). FastLED ships its own
        # fl/stl/asio/http/http_parser.h and references it path-qualified
        # only, so keep its directory off -I or the IDF include resolves to
        # FastLED's file and every httpd_method_t use fails to compile.
        'http_parser.h',
    })

    # arduino-esp32 uses a single library architecture id ("esp32") across
    # every chip variant (esp32 / esp32c3 / esp32s3 ...). A library whose
    # library.properties declares architectures= without "esp32" or "*" is
    # built for another platform and must not be pulled into an ESP32 build.
    _ESP32_LIB_ARCH = 'esp32'

    def _core_provided_headers(self) -> frozenset[str]:
        """Header filenames provided by the arduino-esp32 core itself
        (its `cores/` tree plus every bundled library under `libraries/`).

        These are compiled into the arduino-esp32 IDF component, so a user
        library must NEVER shadow them — even when a lib installed in
        ~/Arduino/libraries happens to ship a file by the same name. The
        canonical break this guards against: `WiFiEspAT/src/WiFi.h` (an
        ESP8266 AT-modem library) shadowing the core `WiFi.h`, which drags
        `EspAtDrv.cpp` into the build where its `const char OK[]` /
        `const char STATUS[]` collide with ESP-IDF's
        `enum STATUS { ...OK... }` in rom/ets_sys.h and the compile fails.

        Computed once from the core tree and cached. Always unions the
        static `_CORE_ESP32_HEADERS` fallback so the guard still holds even
        when the core path is unknown (e.g. translation-only mode).
        """
        cached = getattr(self, '_core_headers_cache', None)
        if cached is not None:
            return cached
        headers: set[str] = set(self._CORE_ESP32_HEADERS)
        # Union both installed cores (2.x and 3.x) so the guard holds
        # whichever one a given build selects.
        for core_path in {self.arduino_path, getattr(self, 'arduino5_path', '')}:
            root = Path(core_path) if core_path else None
            if not (root and root.is_dir()):
                continue
            for sub in ('cores', 'libraries'):
                base = root / sub
                if not base.is_dir():
                    continue
                for pattern in ('*.h', '*.hpp'):
                    for f in base.rglob(pattern):
                        headers.add(f.name)
        result = frozenset(headers)
        self._core_headers_cache = result
        logger.info('[espidf] core-provided header set: %d headers', len(result))
        return result

    @staticmethod
    def _parse_library_properties(lib_root: Path) -> dict[str, str]:
        """Best-effort parse of an Arduino library.properties into a dict."""
        props: dict[str, str] = {}
        try:
            text = (lib_root / 'library.properties').read_text(
                encoding='utf-8', errors='ignore'
            )
        except OSError:
            return props
        for line in text.splitlines():
            line = line.strip()
            if not line or line.startswith('#') or '=' not in line:
                continue
            key, _, value = line.partition('=')
            props[key.strip().lower()] = value.strip()
        return props

    def _library_supports_esp32(self, lib_root: Path) -> bool:
        """True if the library may be used on the ESP32 platform.

        A missing/empty `architectures` field means "all architectures"
        (the Arduino default), so we allow it. Only libraries that
        explicitly enumerate architectures WITHOUT esp32/* are rejected —
        those are written for another platform and would not compile.

        "Does not exclude esp32" is not the same as "builds on esp32", though.
        A library that leaves architectures open (or says `*`) but includes an
        AVR libc header with no condition around it cannot compile here — the
        header does not exist in this toolchain. `evive` is one: its evive.h
        pulls <util/delay.h> unconditionally, and a same-named header dragged
        its whole tree into a user's ESP32 build (issue #352). A library that
        explicitly names esp32 is trusted as written.
        """
        arch = self._parse_library_properties(lib_root).get('architectures', '').strip()
        arches = {a.strip().lower() for a in arch.split(',') if a.strip()}
        if self._ESP32_LIB_ARCH in arches:
            return True
        # 'all' is a common non-spec synonym for '*' (e.g. LiquidCrystal_I2C
        # 2.0.0 declares architectures=all) — treating it as unknown skipped
        # the most popular I2C LCD library on every ESP32 build (issue #257).
        if arches and not ('*' in arches or 'all' in arches):
            return False
        return self._foreign_platform_include(lib_root) is None

    # AVR libc header namespaces. Not a list of headers to refuse: a header in
    # these is refused only if THIS toolchain cannot find it (see below).
    _FOREIGN_INCLUDE_PREFIXES: tuple[str, ...] = ('avr/', 'util/')
    _foreign_include_cache: dict = {}

    def _foreign_platform_include(self, lib_root: Path) -> str | None:
        """The first platform header this library includes UNCONDITIONALLY
        that the ESP32 build cannot provide — or None.

        Conditional includes are fine and common: `#ifdef __AVR__ #include
        <avr/pgmspace.h> #endif` is how a portable library looks. What rules a
        library out is an include no preprocessor condition protects, because
        that line runs on every platform. An include guard does not count as a
        condition (it wraps the whole header on every platform), so an
        `#ifndef X` followed by `#define X` is not counted.

        Whether a header "cannot be provided" is asked of the real include
        roots — the Arduino cores and the IDF components — not of a list, so a
        core that grows an avr/ compatibility header is honoured the day it
        ships one.
        """
        key = str(lib_root)
        if key in self._foreign_include_cache:
            return self._foreign_include_cache[key]
        found: str | None = None
        cores = [r for r in (getattr(self, 'arduino_path', ''),
                             getattr(self, 'arduino5_path', '')) if r]
        idfs = [r for r in (getattr(self, 'idf_path', ''),
                            getattr(self, 'idf5_path', '')) if r]

        def provided(header: str) -> bool:
            # Where an Arduino sketch's <...> can land: the core itself, and
            # the IDF components' public include dirs. One wildcard level
            # each — a recursive walk of the IDF per header would cost
            # seconds, and nothing lives deeper than this.
            for c in cores:
                if next(Path(c).glob(f'cores/*/{header}'), None):
                    return True
            for i in idfs:
                if next(Path(i).glob(f'components/*/include/{header}'), None):
                    return True
                if (Path(i) / 'components' / 'newlib' / 'platform_include' / header).exists():
                    return True
            return False
        include_re = re.compile(r'^\s*#\s*include\s*<([^>]+)>')
        cond_open = re.compile(r'^\s*#\s*(if|ifdef|ifndef)\b')
        cond_close = re.compile(r'^\s*#\s*endif\b')
        guard_open = re.compile(r'^\s*#\s*ifndef\s+(\w+)')
        guard_def = re.compile(r'^\s*#\s*define\s+(\w+)')
        scanned = 0
        for path in sorted(lib_root.rglob('*')):
            if found or scanned > 400:
                break
            if path.suffix.lower() not in ('.h', '.hpp', '.c', '.cpp') or not path.is_file():
                continue
            if any(part in ('examples', 'extras', 'test', 'tests') for part in path.parts):
                continue
            scanned += 1
            try:
                lines = path.read_text(encoding='utf-8', errors='ignore').splitlines()
            except OSError:
                continue
            depth = 0
            guards = 0  # depths opened by an include guard, not a condition
            for i, line in enumerate(lines):
                g = guard_open.match(line)
                if g and i + 1 < len(lines):
                    d = guard_def.match(lines[i + 1])
                    if d and d.group(1) == g.group(1):
                        depth += 1
                        guards += 1
                        continue
                if cond_open.match(line):
                    depth += 1
                    continue
                if cond_close.match(line):
                    depth = max(0, depth - 1)
                    guards = min(guards, depth)
                    continue
                if depth - guards > 0:
                    continue
                m = include_re.match(line)
                if not m:
                    continue
                header = m.group(1).strip()
                if not header.startswith(self._FOREIGN_INCLUDE_PREFIXES):
                    continue
                if (lib_root / header).exists() or provided(header):
                    continue
                found = header
                break
        self._foreign_include_cache[key] = found
        return found

    @staticmethod
    def _norm_lib_name(name: str) -> str:
        """Normalise a library name for manifest matching: lowercased, only
        alphanumerics. So "Adafruit GFX Library", "Adafruit_GFX_Library" and
        "adafruitgfxlibrary" all compare equal — the Library Manager display
        name and the on-disk folder name differ only by separators/case.

        A manifest entry may carry an install/pin suffix after '@'
        ("M5GFX@0.2.26-df5ac6900fe7", "Lib@wokwi:hash"); only the base name
        identifies the library on disk, so the suffix is stripped before
        normalising — otherwise a pinned entry never matches its own folder
        and the compiler treats the lib as undeclared."""
        return ''.join(ch for ch in (name or '').split('@', 1)[0].lower() if ch.isalnum())

    def _library_in_manifest(self, lib_root: Path, allowed_norm: set[str]) -> bool:
        """True if this library is in the project's declared manifest.
        Matches on the on-disk folder name OR the library.properties `name=`
        (the Library Manager display name), both normalised."""
        if self._norm_lib_name(lib_root.name) in allowed_norm:
            return True
        props_name = self._parse_library_properties(lib_root).get('name', '')
        return bool(props_name) and self._norm_lib_name(props_name) in allowed_norm

    def _find_manifest_library_for_header(
        self, header: str, libs_dir: Path, allowed_norm: set[str]
    ) -> Path | None:
        """Like _find_library_for_header, but returns the source root of the
        first library that provides `header` AND is in the project manifest.
        Returns None when no DECLARED library provides the header — so a stray
        same-named lib in the shared dir is never picked up."""
        for lib_dir in sorted(libs_dir.iterdir()):
            if not lib_dir.is_dir():
                continue
            for src_root in (lib_dir, lib_dir / 'src'):
                if (src_root / header).exists() and self._library_in_manifest(
                    lib_dir, allowed_norm
                ):
                    return src_root
        return None

    @staticmethod
    def _missing_library_headers(result: dict) -> list[str]:
        """Extract the header filenames a failed compile reported as missing
        (`fatal error: X.h: No such file or directory`). De-duped, basename
        only. Used to decide whether a manifest-scoped failure is a missing-
        dependency case worth retrying with scan-all."""
        text = '\n'.join(
            str(result.get(k) or '') for k in ('error', 'stderr', 'stdout')
        )
        headers: list[str] = []
        for m in re.finditer(
            r'fatal error:\s*([A-Za-z0-9_./+-]+\.h(?:pp)?)\s*:\s*No such file',
            text,
        ):
            h = m.group(1).split('/')[-1]
            if h not in headers:
                headers.append(h)
        return headers

    @staticmethod
    def _is_transient_build_failure(result: dict) -> bool:
        """True if a failed compile looks like infrastructure flakiness (cmake
        configure, ESP-IDF nested bootloader / managed-components, a missing
        generated sdkconfig.h, a failed CORE esp-idf object) rather than the
        user's sketch. Such failures hit occasionally on a cold variant build
        and clear on a retry — and are NEVER caused by user code, so retrying
        is safe."""
        if result.get('success'):
            return False
        text = (
            str(result.get('error') or '') + '\n'
            + str(result.get('stderr') or '') + '\n'
            + str(result.get('stdout') or '')
        ).lower()
        markers = (
            'managed_components_list.temp.cmake',
            'cmake configure failed',
            'sdkconfig.h: no such file',
            'ninja: error',
            'cmake error',
        )
        if any(m in text for m in markers):
            return True
        # The nested bootloader sub-build failing, matched on ninja's FAILED
        # line. A bare 'esp-idf/bootloader' substring is also part of every
        # app link command (libbootloader_support.a), so it classified every
        # link error as transient and built it twice (587 retries on
        # 2026-09-15, none of which could help).
        return bool(re.search(r'^\s*failed:[^\n]*bootloader', text, re.M))

    def _libraries_for_missing_headers(
        self, headers: list[str], allowed: set[str]
    ) -> tuple[set[str], dict[str, dict]]:
        """Which libraries to add to a scope that could not find `headers` —
        one per header, chosen by authority — and why the others were not.

        This is what a scoped compile's retry widens by, instead of re-running
        the whole include graph against every library on the server. On a
        shared cache that "scan-all" sees libraries OTHER users installed, and
        it resolves by file name, first match wins: a user declaring LovyanGFX,
        TJpg_Decoder, WiFiManager and lvgl had a same-named header pull in the
        entire tree of `evive`, an AVR library someone else had installed, and
        the build died inside it (issue #352; the same shape as Hash.h ->
        stemihexapod before it, which was patched by adding the name to a
        list — a list only covers the names someone has already reported).

        Per header, in order of authority:
          1. a library a DECLARED library lists in its `depends=` — the author
             said so;
          2. a library whose name is the header's (TJpg_Decoder.h ->
             TJpg_Decoder);
          3. the only candidate left, if there is exactly one.
        Every candidate must also be able to build for ESP32. A header two
        unrelated libraries both provide, with nothing to tell them apart, is
        a question for the user, not a guess for the resolver.
        """
        report: dict[str, dict] = {
            h: {'chosen': None, 'rejected': [], 'ambiguous': []} for h in headers
        }
        chosen: set[str] = set()
        libs_dir = self._find_arduino_libraries_dir()
        if not libs_dir or not libs_dir.is_dir():
            return chosen, report
        allowed_norm = {self._norm_lib_name(a) for a in allowed}
        lib_dirs = [d for d in sorted(libs_dir.iterdir()) if d.is_dir()]
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
