davide97g/keybordy/sim/velxio/backend/app/api/routes/iot_gateway.py

"""
IoT Gateway — HTTP reverse proxy for ESP32 web servers running in QEMU.

When an ESP32 sketch starts a WebServer on port 80, QEMU's slirp
networking with hostfwd exposes it on a dynamic host port.  This
endpoint proxies HTTP requests from the browser to that host port,
enabling users to interact with their simulated ESP32 HTTP server.

URL pattern:
    /api/gateway/{client_id}/{path}
    →  http://127.0.0.1:{hostfwd_port}/{path}

The board's page is served under that prefix, not at the origin root, and
sketches do not know it. See _rewrite_html below for what that breaks and
how the injected shim fixes it without touching the sketch.
"""
import asyncio
import json
import logging
import re

import httpx
from fastapi import APIRouter, Request, Response

from app.services.esp32_lib_manager import esp_lib_manager

router = APIRouter()
logger = logging.getLogger(__name__)


# ── Serving a root-relative page under a path prefix ────────────────────────
# A sketch's page is written for a board that owns its whole origin, so it
# asks for "/led?state=1". Served from /api/gateway/<client_id>/ that resolves
# against the app's own origin, misses the proxy entirely, and hits the SPA — which
# answers with its own index.html. The request "succeeds", so the page's own
# .catch() never fires: buttons respond, nothing reaches the board, no error
# anywhere (reported as "webinterface shows the webpage but doesn't send
# information back", velxio#274).
#
# Rewriting the sketch is not an option: root-relative paths are what every
# ESP32 tutorial teaches, and the same sketch must stay correct on real
# hardware. So the shim below is injected into HTML responses and rewrites
# requests in the browser, at the only place that knows the prefix.
#
# It deliberately leaves alone anything already correct: relative paths
# ("led") resolve under the prefix on their own, and so do URLs that already
# carry it.

_GATEWAY_SHIM = """<script>(function(){
var P=%PREFIX%;
if(window.__velxioGatewayShim)return;window.__velxioGatewayShim=P;
/* The emulated subnets (ESP32 via QEMU slirp, and the in-browser virtual
   net). A sketch that prints its own IP into the page hard-codes one of these. */
var BOARD=/^(192\\.168\\.4\\.\\d{1,3}|10\\.13\\.37\\.\\d{1,3})$/;
function rw(u){
  try{
    if(u==null)return u;
    var s=String(u);
    if(!s)return u;
    if(s.slice(0,2)==='//'||/^[a-z][a-z0-9+.-]*:/i.test(s)){
      try{
        var a=new URL(s,location.href);
        if((a.protocol==='http:'||a.protocol==='https:')&&BOARD.test(a.hostname))
          return P+a.pathname.replace(/^\\//,'')+a.search+a.hash;
      }catch(e){}
      return u;
    }
    if(s.charAt(0)!=='/')return u;      /* relative: already resolves right */
    if(s.indexOf(P)===0)return u;       /* already prefixed */
    return P+s.slice(1);
  }catch(e){return u;}
}
window.__velxioGatewayRewrite=rw;
var of=window.fetch;
if(of)window.fetch=function(i,o){
  try{
    if(typeof i==='string'||i instanceof URL)i=rw(String(i));
    else if(typeof Request!=='undefined'&&i instanceof Request){
      var n=rw(i.url);if(n!==i.url)i=new Request(n,i);
    }
  }catch(e){}
  return of.call(this,i,o);
};
var ox=XMLHttpRequest.prototype.open;
XMLHttpRequest.prototype.open=function(m,u){
  var a=Array.prototype.slice.call(arguments);
  try{a[1]=rw(u);}catch(e){}
  return ox.apply(this,a);
};
if(window.EventSource){
  var OE=window.EventSource;
  var NE=function(u,c){return new OE(rw(u),c);};
  NE.prototype=OE.prototype;
  ['CONNECTING','OPEN','CLOSED'].forEach(function(k){NE[k]=OE[k];});
  window.EventSource=NE;
}
if(window.WebSocket){
  /* The proxy is plain HTTP: it cannot carry an Upgrade. Say so once, in the
     place the developer is already looking, instead of failing silently. */
  var OW=window.WebSocket;
  var NW=function(u,p){
    try{
      var a=new URL(String(u),location.href);
      if(BOARD.test(a.hostname))
        console.warn('[velxio] WebSocket to '+a.host+' cannot be proxied: the '+
          'IoT gateway forwards HTTP only. HTTP routes and Server-Sent Events work.');
    }catch(e){}
    return p===undefined?new OW(u):new OW(u,p);
  };
  NW.prototype=OW.prototype;
  ['CONNECTING','OPEN','CLOSING','CLOSED'].forEach(function(k){NW[k]=OW[k];});
  window.WebSocket=NW;
}
function fix(el){
  ['src','href','action'].forEach(function(at){
    if(!el.getAttribute)return;
    var v=el.getAttribute(at);
    if(v==null||v==='')return;
    if(v.charAt(0)==='#')return;
    var n=rw(v);
    if(n!==v)el.setAttribute(at,n);
  });
}
function sweep(root){
  try{
    if(root.querySelectorAll)
      Array.prototype.forEach.call(root.querySelectorAll('[src],[href],[action]'),fix);
    if(root.nodeType===1)fix(root);
  }catch(e){}
}
if(document.readyState==='loading')
  document.addEventListener('DOMContentLoaded',function(){sweep(document);});
else sweep(document);
try{
  new MutationObserver(function(ms){
    ms.forEach(function(m){
      Array.prototype.forEach.call(m.addedNodes,function(n){if(n.nodeType===1)sweep(n);});
      if(m.type==='attributes'&&m.target)fix(m.target);
    });
  }).observe(document.documentElement,{childList:true,subtree:true,
    attributes:true,attributeFilter:['src','href','action']});
}catch(e){}
})();</script>"""

_HEAD_RE = re.compile(rb'<head[^>]*>', re.IGNORECASE)
_HTML_RE = re.compile(rb'<html[^>]*>', re.IGNORECASE)


# ── Saying "there is no server here" so the user can read it ────────────────
# Two things ate every word of the old answer.
#
# The status: a proxy with nothing to proxy to is a textbook 502, but a CDN
# or reverse proxy in front of this server may replace an origin 502 (and 504)
# with its own interstitial, eating the careful explanation below. So these
# answers carry a 4xx, which proxies pass through untouched; the
# machine-readable `error` key keeps the distinction a 502 used to carry.
#
# The body: the frontend opens the gateway with window.open(_blank), so a JSON
# body dumps as raw text in a fresh tab. Content-negotiate: HTML to a browser
# navigation, JSON to fetch/XHR.
_ERROR_PAGE_CSS = (
    'body{background:#1e1e1e;color:#ddd;font-family:-apple-system,'
    'BlinkMacSystemFont,sans-serif;display:flex;min-height:100vh;margin:0;'
    'align-items:center;justify-content:center;text-align:center}'
    '.box{max-width:520px;padding:32px}h1{font-size:20px;color:#fff}'
    'p{color:#aaa;line-height:1.6;font-size:14px}'
    'code{background:#2a2a2a;color:#ddd;padding:2px 6px;border-radius:4px}'
)


def _gateway_error(
    request: Request,
    *,
    error: str,
    title: str,
    html_body: str,
    message: str,
    status_code: int,
) -> Response:
    """The one shape every dead end of this proxy answers with."""
    if 'text/html' in (request.headers.get('accept') or ''):
        return Response(
            content=(
                '<!doctype html><html><head><meta charset="utf-8">'
                f'<title>Velxio — {title}</title>'
                '<meta name="viewport" content="width=device-width, initial-scale=1">'
                f'<style>{_ERROR_PAGE_CSS}</style></head><body><div class="box">'
                f'<h1>{title}</h1>{html_body}'
                '</div></body></html>'
            ),
            status_code=status_code,
            media_type='text/html',
        )
    return Response(
        content=json.dumps({'error': error, 'message': message}),
        status_code=status_code,
        media_type='application/json',
    )


_NO_SERVER_MESSAGE = (
    'The board is on the network, but nothing answered on port 80. The IoT '
    'gateway forwards HTTP to a web server your sketch starts — a sketch that '
    'only reads sensors, prints to the serial monitor or POSTs to a cloud API '
    'has no page to show. Start a server (WebServer on Arduino, socket / '
    'microdot on MicroPython) and listen on port 80.'
)

_NO_SERVER_HTML = (
    '<p>The board is on the network, but nothing answered on port 80.</p>'
    '<p>This gateway forwards HTTP to a <b>web server your sketch starts</b>. '
    'A sketch that only reads sensors, prints to the serial monitor or POSTs '
    'to a cloud API has no page to serve — there is nothing broken here, and '
    'the simulation keeps running.</p>'
    '<p>To get a page: listen on port 80 (<code>WebServer</code> on Arduino, '
    '<code>socket</code> or microdot on MicroPython), then open this link '
    'again once the sketch prints that the server started.</p>'
)


def no_server_response(request: Request) -> Response:
    """The board is reachable, but nothing is listening on port 80."""
    return _gateway_error(
        request,
        error='no_server_on_board',
        title='No web server on this board',
        html_body=_NO_SERVER_HTML,
        message=_NO_SERVER_MESSAGE,
        status_code=404,
    )


def _gateway_prefix(request: Request, path: str) -> str:
    """The '/api/gateway/<client_id>/' this request came through, taken from
    the request itself so it carries the browser's own encoding of the id."""
    req_path = request.url.path
    if path and req_path.endswith(path):
        prefix = req_path[: len(req_path) - len(path)]
    else:
        prefix = req_path
    return prefix if prefix.endswith('/') else prefix + '/'


def _rewrite_html(resp: Response, prefix: str) -> Response:
    """Inject the shim into an HTML response. Any other content type, or a
    body we cannot decode, is passed through untouched."""
    ctype = resp.media_type or resp.headers.get('content-type') or ''
    if 'html' not in ctype.lower():
        return resp
    body = resp.body
    if not body:
        return resp
    shim = _GATEWAY_SHIM.replace('%PREFIX%', json.dumps(prefix)).encode('utf-8')

    m = _HEAD_RE.search(body) or _HTML_RE.search(body)
    # Straight after <head> (or <html>) so the shim is installed before any of
    # the page's own script runs; a fragment with neither gets it up front.
    new_body = body[: m.end()] + shim + body[m.end():] if m else shim + body

    headers = {
        k: v for k, v in resp.headers.items()
        # Recomputed by the Response below; a stale one truncates the page.
        if k.lower() not in ('content-length', 'content-encoding')
    }
    return Response(
        content=new_body,
        status_code=resp.status_code,
        headers=headers,
        media_type=resp.media_type or ctype,
    )


@router.api_route(
    '/{client_id}/{path:path}',
    methods=['GET', 'POST', 'PUT', 'DELETE', 'PATCH', 'HEAD', 'OPTIONS'],
)
async def gateway_proxy(client_id: str, path: str, request: Request) -> Response:
    """Reverse-proxy an HTTP request to the ESP32's web server."""
    # Registration races the sketch printing its URL: a fast click on the
    # link the serial monitor shows can reach here before the instance has
    # registered its hostfwd port. Poll briefly before giving up.
    for attempt in range(5):
        if attempt:
            await asyncio.sleep(0.25)

        # ── ESP32: the server runs in QEMU, reachable via slirp hostfwd. ──
        inst = esp_lib_manager.get_instance(client_id)
        if inst and inst.wifi_enabled and inst.wifi_hostfwd_port != 0:
            return _rewrite_html(
                await _proxy_esp32(inst, path, request),
                _gateway_prefix(request, path),
            )

    # Wording matters here. The old text said "make sure your sketch connected
    # to WiFi", which reads as an accusation to the one sketch that most often
    # lands on this branch: a captive-portal / provisioning sketch that called
    # WiFi.softAP() and deliberately did NOT join a network. Such a board is
    # the access point, so it never gets a DHCP lease, never reaches 'got_ip',
    # and never registers the bridge this proxy looks up — there is nothing to
    # reach and nothing the user did wrong. Name that case first.
    return _gateway_error(
        request,
        error='no_reachable_board',
        title='No board to reach',
        html_body=(
            '<p>Nothing is registered for this simulation, so there is no '
            'server to reach.</p>'
            '<p>If your sketch calls <code>WiFi.softAP()</code>, that is why: '
            'the simulator can reach a board that <b>joined</b> a network, not '
            'one that created one. Join a simulated network instead — '
            '<code>WiFi.begin("Velxio-GUEST")</code>, open, no password — and '
            'start your server on port 80.</p>'
            '<p>If the sketch does join a network, wait for it to print its IP '
            'before opening the gateway.</p>'
        ),
        message=(
            'Nothing is registered for this client, so there is no server '
            'to reach. If your sketch calls WiFi.softAP(), that is why: '
            'the simulator can reach a board that JOINED a network, not a '
            'board that created one. Join a simulated network instead '
            '(WiFi.begin("Velxio-GUEST") — open, no password) and start '
            'your server on port 80. If the sketch does join a network, '
            'wait for it to print its IP before opening the gateway.'
        ),
        status_code=404,
    )


async def _proxy_esp32(inst, path: str, request: Request) -> Response:
    """Reverse-proxy to an ESP32 web server via QEMU slirp hostfwd."""
    target_url = f'http://127.0.0.1:{inst.wifi_hostfwd_port}/{path}'
    body = await request.body()

    # Forward relevant headers (skip hop-by-hop)
    skip_headers = {'host', 'transfer-encoding', 'connection'}
    headers = {
        k: v for k, v in request.headers.items()
        if k.lower() not in skip_headers
    }

    try:
        async with httpx.AsyncClient(timeout=10.0) as client:
            resp = await client.request(
                method=request.method,
                url=target_url,
                content=body,
                headers=headers,
            )
    except httpx.ConnectError:
        return no_server_response(request)
    except httpx.TimeoutException:
        return _gateway_error(
            request,
            error='board_server_timeout',
            title='The board did not answer in time',
            html_body=(
                '<p>A web server is listening on this board, but it did not '
                'finish the reply within 10 seconds.</p>'
                '<p>The emulated CPU runs slower than real silicon, so a '
                'handler that blocks — a long <code>delay()</code>, a sensor '
                'read in the request path — can overrun. Keep the simulation '
                'tab in the foreground and try again.</p>'
            ),
            message=(
                'The board\'s HTTP server did not answer within 10 seconds. '
                'Keep the simulation tab in the foreground and avoid blocking '
                'work inside the request handler.'
            ),
            status_code=408,
        )

    # Forward response back to browser
    resp_headers = dict(resp.headers)
    # Remove hop-by-hop headers
    for h in ('transfer-encoding', 'connection', 'content-encoding'):
        resp_headers.pop(h, None)

    return Response(
        content=resp.content,
        status_code=resp.status_code,
        headers=resp_headers,
        media_type=resp.headers.get('content-type'),
    )
