davide97g/keybordy/(commit log)

2026-09-29 Initial commit: ESP32 8-key keyboard, firmware and local simulator
    - firmware/keys8: 8 switches on jumpers only, two pins per switch,
    GPIO-driven grounds; Wokwi diagram.json and wokwi.toml
    - firmware/switches_oled, firmware/rotary_oled: earlier OLED sketches
    - sim: Velxio in Docker behind an nginx proxy that autoloads keys8
    at http://localhost:3080/editor
    - docs: board, bench and wiring notes
    - guide: interactive wiring guide (Vite + React)
2026-09-29 chore(sim): vendor Velxio 273a0ca (AGPLv3) as sim/velxio
    Shallow copy of https://github.com/davidmonterocrespo24/velxio at
    273a0ca0aa79b193050dfdbde960eb1c0347ed36 (2026-09-28), without git
    history, CI, docs, tests, the VS Code extension, MCP servers and the
    commercial license file. Unmodified; changes follow in later commits.
    [partitions.csv]
2026-09-29 feat(sim): de-pro the vendored Velxio and build it locally
    Turn sim/velxio into a single-user, local-only fork:
    - Remove the private-overlay seams (@pro alias, lib/pro* gates, overlay
    slots, backend core/hooks.py, priority lanes) and every paywall UI:
    PRO badges, ONLINE ad cards, paid SD/flash gates, upgrade prompts.
    SD uploads and library uninstall are free.
    - Remove accounts and sharing (Account menu, My projects, Share, GitHub
    sync, recording, BOM/screenshot export) and hosted cruft (analytics,
    telemetry, news, star prompt, SEO prerender, desktop shell, MCP).
    - Hide Raspberry Pi Linux and STM32 boards and examples: their emulators
    are not open source.
    - Load projects from /ed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
2026-09-29 feat(sim): restyle the editor as keybordy "Procedure Online"
    Rebrand the vendored Velxio editor to keybordy and give it a dark-only
    theme taken from the chosen design direction: black ground, acid lime and
    hot pink as signal colors, lavender as secondary.
    - Tokens: new palette in tokens/colors.css; the light theme and theme
    toggle are removed and lib/theme.ts always resolves to dark.
    - Type: self-hosted Anybody (display), Geist (UI) and Martian Mono (code,
    pins, serial) replace Inter and JetBrains Mono.
    - Toolbar: Run is a labeled lime pill that reads "Running" while the board
    runs, Stop a pink outline pill; Libraries and Add part are neutral.
    - Panels: hatched headers, wider explorer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
2026-09-29 feat(sim): Bun + uv tooling, Postgres project store, faster dev loop
    - Frontend and guide install with Bun from committed bun.lock files;
    scripts run through `bun run` (vitest/eslint still on Node). Drop the
    unused canvas devDependency and the tsx-only root package.json.
    - Backend moves from pip/requirements.txt to uv (pyproject.toml, uv.lock),
    with pytest and a narrow ruff config; fix the stale pytest testpaths.
    - Saved projects in Postgres: compose postgres service, SQLAlchemy async
    models, Alembic migrations run at boot, /api/projects with optimistic
    autosave (409 on stale revision, 503 when the DB is down). The editor
    gets File > Projects… / Save to projects…, ?id=<uuid>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
2026-09-29 feat(sim): logo sticker animation for boot and compile
    The keybordy mark as a die-cut vinyl sticker (lime keycap K, white
    border, peeling corner, gloss sweep) that slaps onto the screen and
    keeps pressing its key while something loads.
    - Boot splash painted inline in index.html, so it animates before any
    JS loads: sticker, wordmark, and eight mini keycaps lighting up in
    the K1..K8 colors. EditorPage peels it off once the workspace has
    loaded; other routes drop it at once; a 15 s fallback removes it if
    the app never boots.
    - The compile card wears the sticker on its corner instead of the
    spinner: it presses while building, pops a check on success, turns
    pink and shakes with a cro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
2026-09-29 feat(sim): keycap and sticker motion across the editor
    One motion vocabulary everywhere: keycaps press into a skirt, stickers
    slap in and peel.
    - Boot: the splash sticker flies into the header mark, which catches
    it; the title types itself in. Header mark lifts into a sticker on
    hover and presses on click; the title ripples like a row of keys.
    - Key HUD on the canvas: one cap per K<n> part, lit in its cap color
    while the firmware's serial output says the key is down, with a
    press counter. Each `key N down` also rings the part on the canvas.
    - Run is a keycap with an ignite ring when the board goes live and a
    rolling label; Stop gets a press. The status bar stamps state changes
    a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
2026-09-29 feat(sim): headless simcheck harness for firmware and wiring
    sim/harness/simcheck.py lints diagram.json against the sketch's
    KEY_PINS/GND_PINS and the README pin table, then runs the firmware in
    the simulator's QEMU worker without a browser: it solves the switch
    nets itself, presses keys from a scenario script and asserts on serial
    output (boot loops, panics, shorts, floating inputs, missing or extra
    key lines).
    - just sim-lint / sim-run / sim-check wrap it; compiles go through the
    simulator's /api/compile/ and are cached in sim/.cache/.
    - A project sim-check skill and allowlist in .claude/ so Claude runs it
    after firmware or wiring edits.
    - CLAUDE.md and sim/README.md document the harn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
    [simcheck.py]
2026-09-30 feat(sim): flash and monitor the real ESP32 over Web Serial
    A device dock on the toolbar shows whether the paired board is on USB
    (status LED that slaps on at plug-in and peels at unplug), a Flash button
    that fills as its own progress bar, and an Attach toggle.
    Flash builds if the code changed, then writes the simulator's own ESP32
    image with esptool-js, skipping the NVS partition and verifying each
    region's MD5. A progress card steps through Build, Connect, Write, Verify
    and Boot and ends on the board's first serial line after the reset.
    Attach streams the board's serial into a USB tab of the serial monitor;
    while attached the key HUD follows the real switches. The status bar
    gets a USB i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
2026-09-30 feat(sim): pin map panel for the clicked part or board
    A left click on a part or board opens a sheet on the canvas's right edge
    listing every pin and where its wire goes, grouped into board inputs,
    outputs, power and ground, and unconnected pins. Board GPIOs show their
    direction, pull and level from the PinManager while the sketch runs, and
    keep the last run's values after it stops; a part's pins borrow the role
    of the board pin at the far end.
    The canvas follows: the part's wires glow and the rest dim, the parts at
    the far ends get a ring in their wire's color, and hovering a row narrows
    it to one pin. Clicking a peer walks to it, and the bench pans left when
    the panel would cover the clic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
2026-09-30 feat: Bluetooth keyboard firmware and Mac keymap editor
    keys8 now pairs as a BLE HID keyboard named keybordy and sends F13-F20
    for K1-K8, still printing key N down/up on serial. BLE is skipped in the
    simulator (QEMU's default MAC), where BLEDevice::init stalls the chip.
    host/ holds the Mac side: Hammerspoon binds F13-F20 to actions from
    ~/.config/keybordy/keymap.json (app, Ghostty terminal, shell, URL,
    Shortcut, key combo, text, media key) and serves a keymap editor on
    localhost:7373 in the simulator editor's style. The editor shows each
    key's action, edits and saves it, and simulates presses with an
    activity log. The API is loopback-only and token-protected, and checks
    Host and Origin.
    Co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
    [keys8.ino]
2026-10-07 feat(pcb): rev A carrier board generated from pcb/build.py
    KiCad 10 board with the DevKit, OLED and KY-040 on female headers and
    8 Kailh MX hotswap sockets on the back. build.py places, routes on fixed
    coordinates and exports DRC-checked Gerbers; just pcb-build/pcb-fab/pcb-open.
    [keybordy.kicad_pcb]
2026-10-20 feat(cad): publish the macropad STLs for the portfolio 3D section
    The seven printed parts of keybordy MP, exported from cad/macropad.py on
    feat/macropad, plus a 3d.json that names them and sets their filament.
    davideghiotto.it picks the repo up through the 3d-printing topic and
    renders these files live.
